SimonDavidson/FlexMan/scheduler/sch_buffer_state.v

// SPDX-License-Identifier: MIT
// Copyright (c) 2026 Simon Davidson, University of Manchester
////////////////////////////////////////////////////////////////////////
//
// sch_buffer_state
//
// Author: Simon D.
// Version: 2.1
// Authors: Simon Davidson & Claude   Last modified: 2026-10-12
//
// Tracks buffer and accelerator state for the scheduler.
//
// Each TASK carries NUM_SLOTS buffer slots, each with a 2-bit mode:
//   2'b00 unused  — skip
//   2'b01 source  — consume (decrement usage count) on completion
//   2'b10 rw      — claim (free=0, full=0) on dispatch; refill on completion
//   2'b11 target  — reserve (free=0) on dispatch; fill on completion
//
// On completion, slots with mode 10 or 11 are marked full with the
// stored #targets count from the completing task.
//
// OVERLAP_ACC_MASK (2026-08-22, Simon Davidson & Claude)
// ------------------------------------------------------
// Default 0 = every accelerator behaves exactly as before.  A set bit gives
// that accelerator a 2-deep buffer tracker, letting it accept its next task
// while the current one drains its output stage (see acc_hw_buffer_tracker's
// DEPTH).  Masked accelerators must drive acc_ready_next_i.
//
// Masked accelerators also get a 2-bit pending-completion counter instead of
// the single pending BIT.  With two tasks in flight, two acc_finished_i pulses
// arriving within one cycle would otherwise be merged by
//    (pending | finished) & ~selected
// and one completion lost for good — its buffers never freed, the scheduler
// stalled.  Unmasked accelerators keep the original single-bit expression
// verbatim, so nothing existing changes.
//
// OVERLAP_DEPTH (2026-10-12): how many tasks a MASKED accelerator may hold in
// flight. Default 2 = exactly the above. 3 gives it a 3-deep tracker
// (acc_hw_buffer_tracker gen_depthn) and a 3-bit pending counter (up to three
// completions may then be outstanding). Unmasked accelerators are unaffected.
//

`define MODE_UNUSED 2'b00
`define MODE_SRC    2'b01
`define MODE_RW     2'b10
`define MODE_TGT    2'b11

module sch_buffer_state
      #(parameter NUM_BUFFERS         = 16,
        parameter BUFF_INDX_SZ        = $clog2(NUM_BUFFERS),
        parameter NUM_HW_ACCELERATORS = 2,
        parameter TGT_ACC_SZ          = $clog2(NUM_HW_ACCELERATORS),
        parameter TGT_COUNT_SZ        = 3,
        parameter NUM_SLOTS           = 6,
        parameter MODE_SZ             = 2,
        // One bit per accelerator; 1 = allow a second task in flight.
        parameter OVERLAP_ACC_MASK    = {NUM_HW_ACCELERATORS{1'b0}},
        // Tasks in flight for a masked accelerator (2 or 3); default 2.
        parameter OVERLAP_DEPTH       = 2,
        // 1 = buffers tolerate more than one outstanding writer (needed with
        // sch_entry's disjoint hint). Default 0 = original behaviour.
        parameter MULTI_WRITER        = 0
       )
       (input  wire                    clk,
        input  wire                    reset,

        // Process info from hardware accelerators:
        input wire [NUM_HW_ACCELERATORS-1:0] acc_busy_i,
        input wire [NUM_HW_ACCELERATORS-1:0] acc_finished_i,
        input wire [NUM_HW_ACCELERATORS-1:0] acc_result_i,

        // Per-accelerator "I can take another task now" level.  Consulted only
        // for accelerators set in OVERLAP_ACC_MASK; tie to 0 otherwise.
        input wire [NUM_HW_ACCELERATORS-1:0] acc_ready_next_i,

        // External buffer pre-fill:
        input wire                     mark_buff_as_full_i,
        input wire  [BUFF_INDX_SZ-1:0] full_buff_id_i,
        input wire  [TGT_COUNT_SZ-1:0] full_buff_usage_i,

        // Dispatch interface from scheduler:
        input wire                                start_new_task_i,
        input wire  [TGT_ACC_SZ-1:0]              tgt_acc_id_i,
        input wire  [NUM_SLOTS*BUFF_INDX_SZ-1:0]  slot_buff_i,
        input wire  [NUM_SLOTS*MODE_SZ-1:0]        slot_mode_i,
        input wire  [NUM_SLOTS*TGT_COUNT_SZ-1:0]   slot_ntgt_i,
        input wire                                 tgt_colour_i,

        // Broadcast current accelerator status:
        output wire [NUM_HW_ACCELERATORS-1:0] acc_available_o,

        // Broadcast current buffer status:
        output wire [NUM_BUFFERS-1:0]  buffers_full_o,
        output wire [NUM_BUFFERS-1:0]  buffers_free_o,
        output wire [NUM_BUFFERS-1:0]  buffers_colour_o,
        output wire [NUM_BUFFERS-1:0]  target_status_o
        );

// Per-accelerator tracker outputs:
wire [NUM_HW_ACCELERATORS-1:0]             acc_free;
wire [NUM_SLOTS*BUFF_INDX_SZ-1:0] tr_slot_buff [0:NUM_HW_ACCELERATORS-1];
wire [NUM_SLOTS*MODE_SZ-1:0]       tr_slot_mode [0:NUM_HW_ACCELERATORS-1];
wire [NUM_SLOTS*TGT_COUNT_SZ-1:0]  tr_slot_ntgt [0:NUM_HW_ACCELERATORS-1];

// Pending-completion queue (one-hot, one bit per accelerator):
reg  [NUM_HW_ACCELERATORS-1:0] acc_process_pending_r;
wire [NUM_HW_ACCELERATORS-1:0] acc_process_pending_nxt;

// Selected finisher (combinatorial):
reg  [NUM_HW_ACCELERATORS-1:0] selected_finisher;
reg  [TGT_ACC_SZ-1:0]          selected_acc_idx;
wire                            post_task_cleanup;

// One-hot buffer action strobes (combinatorial):
reg  [NUM_BUFFERS-1:0] buff_src_consumed;
reg  [NUM_BUFFERS-1:0] buff_rw_claim;
reg  [NUM_BUFFERS-1:0] buff_new_tgt;
reg  [NUM_BUFFERS-1:0] buff_now_full;

// Per-buffer completion data (driven from selected finisher's tracker):
reg  [TGT_COUNT_SZ-1:0] buff_now_ntgt   [0:NUM_BUFFERS-1];

// External mark-as-full one-hot:
reg  [NUM_BUFFERS-1:0] mark_as_full;

// ACC ID one-hot for new task dispatch:
reg [NUM_HW_ACCELERATORS-1:0] new_task_acc;

integer s, c, bi_idx;
reg found;

//-----------------------------------------------------------------
// Pending-completion queue
//-----------------------------------------------------------------
genvar pi;
generate
   for (pi = 0; pi < NUM_HW_ACCELERATORS; pi = pi + 1) begin : gen_pend
      if (((OVERLAP_ACC_MASK >> pi) & 1) == 0) begin : gen_bit
         // Original: at most one completion can ever be outstanding.
         assign acc_process_pending_nxt[pi] =
                  (acc_process_pending_r[pi] | acc_finished_i[pi])
                & ~selected_finisher[pi];
      end else if (OVERLAP_DEPTH >= 3) begin : gen_cntn
         // OVERLAP_DEPTH>=3: up to OVERLAP_DEPTH completions outstanding, so
         // the counter is one bit wider than that needs and must never fill.
         localparam CW = $clog2(OVERLAP_DEPTH + 1) + 1;
         reg  [CW-1:0] cnt_r;
         wire [CW-1:0] cnt_nxt = cnt_r + {{(CW-1){1'b0}}, acc_finished_i[pi]}
                                       - {{(CW-1){1'b0}}, selected_finisher[pi]};
         always @ (posedge clk)
            if (reset) cnt_r <= {CW{1'b0}};
            else       cnt_r <= cnt_nxt;
         assign acc_process_pending_nxt[pi] = (cnt_nxt != {CW{1'b0}});
         // synopsys translate_off
         always @ (posedge clk)
            if (!reset && cnt_r > OVERLAP_DEPTH) begin
               $display("FATAL %m: %0d completions pending, more than OVERLAP_DEPTH %0d",
                        cnt_r, OVERLAP_DEPTH);
               $fatal;
            end
         // synopsys translate_on
      end else begin : gen_cnt
         // Overlapped: count completions so two cannot merge.  Saturates at 3,
         // which is unreachable with a 2-deep tracker but keeps the adder safe.
         reg  [1:0] cnt_r;
         wire       inc     = acc_finished_i[pi] & (cnt_r != 2'd3);
         wire [1:0] cnt_nxt = cnt_r + {1'b0, inc}
                                    - {1'b0, selected_finisher[pi]};
         always @ (posedge clk)
            if (reset) cnt_r <= 2'd0;
            else       cnt_r <= cnt_nxt;
         assign acc_process_pending_nxt[pi] = (cnt_nxt != 2'd0);
      end
   end
endgenerate

always @ (posedge clk)
begin
   if (reset)
      acc_process_pending_r <= 'b0;
   else
      acc_process_pending_r <= acc_process_pending_nxt;
end

//-----------------------------------------------------------------
// Priority-encode the lowest-index pending finisher
//-----------------------------------------------------------------
always @*
begin
   selected_finisher = 'b0;
   selected_acc_idx  = 'b0;
   found             = 1'b0;
   for (s = 0; s < NUM_HW_ACCELERATORS; s = s + 1)
      if (!found && acc_process_pending_r[s])
      begin
         selected_finisher[s] = 1'b1;
         selected_acc_idx     = s[TGT_ACC_SZ-1:0];
         found                = 1'b1;
      end
end

assign post_task_cleanup = |selected_finisher;

//-----------------------------------------------------------------
// External mark-as-full
//-----------------------------------------------------------------
always @ (full_buff_id_i, mark_buff_as_full_i)
begin
   mark_as_full = 'b0;
   if (mark_buff_as_full_i)
      mark_as_full[full_buff_id_i] = 1'b1;
end

//-----------------------------------------------------------------
// Dispatch: decode slot modes and assert buffer action strobes
//-----------------------------------------------------------------
always @*
begin
   buff_rw_claim     = 'b0;
   buff_new_tgt      = 'b0;
   new_task_acc      = 'b0;
   if (start_new_task_i)
   begin
      new_task_acc[tgt_acc_id_i] = 1'b1;
      for (s = 0; s < NUM_SLOTS; s = s + 1)
      begin : dispatch_slot
         reg [BUFF_INDX_SZ-1:0] bid;
         reg [MODE_SZ-1:0]      md;
         bid = slot_buff_i[s*BUFF_INDX_SZ +: BUFF_INDX_SZ];
         md  = slot_mode_i[s*MODE_SZ      +: MODE_SZ];
         case (md)
            `MODE_RW:  buff_rw_claim[bid] = 1'b1;
            `MODE_TGT: buff_new_tgt[bid]  = 1'b1;
            // MODE_SRC: consume now happens on task completion (see below), not
            // dispatch — accelerators stream the buffer live until they finish,
            // so the buffer must stay allocated until the reader completes.
            default:   ;
         endcase
      end
   end
end

//-----------------------------------------------------------------
// Completion: mark output slots full with stored #targets
//-----------------------------------------------------------------
always @*
begin
   buff_now_full     = 'b0;
   buff_src_consumed = 'b0;
   for (bi_idx = 0; bi_idx < NUM_BUFFERS; bi_idx = bi_idx + 1)
      buff_now_ntgt[bi_idx] = 'b0;

   if (post_task_cleanup)
   begin
      for (s = 0; s < NUM_SLOTS; s = s + 1)
      begin : completion_slot
         reg [BUFF_INDX_SZ-1:0] bid;
         reg [MODE_SZ-1:0]      md;
         bid = tr_slot_buff[selected_acc_idx][s*BUFF_INDX_SZ +: BUFF_INDX_SZ];
         md  = tr_slot_mode[selected_acc_idx][s*MODE_SZ      +: MODE_SZ];
         if (md == `MODE_RW || md == `MODE_TGT)
         begin
            buff_now_full[bid]   = 1'b1;
            buff_now_ntgt[bid]   =
               tr_slot_ntgt[selected_acc_idx][s*TGT_COUNT_SZ +: TGT_COUNT_SZ];
         end
         else if (md == `MODE_SRC)
            // Decrement the read usage-count (and free on the last consumer)
            // when the consuming task COMPLETES, not when it dispatches — closes
            // the write-after-read hazard against accelerators that stream the
            // buffer live from shared memory.
            buff_src_consumed[bid] = 1'b1;
      end
   end
end

//-----------------------------------------------------------------
// Instantiate per-accelerator buffer trackers
//-----------------------------------------------------------------
genvar ai;
generate
   for (ai = 0; ai < NUM_HW_ACCELERATORS; ai = ai + 1) begin : gen_acc
      acc_hw_buffer_tracker #(
         .NUM_SLOTS(NUM_SLOTS),
         .BUFF_INDX_SZ(BUFF_INDX_SZ),
         .TGT_COUNT_SZ(TGT_COUNT_SZ),
         .MODE_SZ(MODE_SZ),
         .DEPTH((((OVERLAP_ACC_MASK >> ai) & 1) != 0) ? OVERLAP_DEPTH : 1)
      ) hw_n (
         .clk(clk),
         .reset(reset),
         .new_task_i(new_task_acc[ai]),
         .slot_buff_i(slot_buff_i),
         .slot_mode_i(slot_mode_i),
         .slot_ntgt_i(slot_ntgt_i),
         .task_finished_i(selected_finisher[ai]),
         .acc_ready_next_i(acc_ready_next_i[ai]),
         .acc_free_o(acc_free[ai]),
         .slot_buff_o(tr_slot_buff[ai]),
         .slot_mode_o(tr_slot_mode[ai]),
         .slot_ntgt_o(tr_slot_ntgt[ai])
      );
   end
endgenerate

assign acc_available_o = acc_free;

//-----------------------------------------------------------------
// Instantiate per-buffer state entries
//-----------------------------------------------------------------
genvar bi;
generate
   for (bi = 0; bi < NUM_BUFFERS; bi = bi + 1) begin : gen_buf
      buffer_state_entry #(.TGT_COUNT_SZ(TGT_COUNT_SZ),
                           .MULTI_WRITER(MULTI_WRITER)) buffer_n (
         .clk(clk),
         .reset(reset),
         .mark_as_full_i(mark_as_full[bi]),
         .mark_buff_usage_i(full_buff_usage_i),
         .buff_new_tgt_i(buff_new_tgt[bi]),
         .buff_new_usage_count_i({TGT_COUNT_SZ{1'b0}}),
         .buff_new_colour_i(tgt_colour_i),
         .buff_rw_claim_i(buff_rw_claim[bi]),
         .buff_rw_colour_i(tgt_colour_i),
         .buff_now_full_i(buff_now_full[bi]),
         .buff_now_usage_count_i(buff_now_ntgt[bi]),
         .buff_content_consumed_i(buff_src_consumed[bi]),
         .buff_usage_count_o(),
         .buff_colour_o(buffers_colour_o[bi]),
         .buff_free_o(buffers_free_o[bi]),
         .buff_full_o(buffers_full_o[bi])
      );
   end
endgenerate

//-----------------------------------------------------------------
// Per-buffer task result register file (used by CHECK instruction)
//-----------------------------------------------------------------
reg [NUM_BUFFERS-1:0] target_status_r;

always @ (posedge clk)
begin
   if (reset)
      target_status_r <= 'b0;
   else if (post_task_cleanup)
   begin
      for (s = 0; s < NUM_SLOTS; s = s + 1)
      begin : result_slot
         reg [BUFF_INDX_SZ-1:0] bid;
         reg [MODE_SZ-1:0]      md;
         bid = tr_slot_buff[selected_acc_idx][s*BUFF_INDX_SZ +: BUFF_INDX_SZ];
         md  = tr_slot_mode[selected_acc_idx][s*MODE_SZ      +: MODE_SZ];
         if (md == `MODE_TGT || md == `MODE_RW)
            target_status_r[bid] <= acc_result_i[selected_acc_idx];
      end
   end
end

assign target_status_o = target_status_r;

endmodule // sch_buffer_state
