SimonDavidson/FlexMan/ipSnnAcc/update_state_for_neuron.v

// SPDX-License-Identifier: MIT
// Copyright (c) 2026 Simon Davidson, University of Manchester
// =============================================================================
// Module: update_state_for_neuron
//
// 3-cycle pipeline (was 2-cycle).  The extra stage registers the potential
// multiplier output and spike before the output mux, breaking the previously
// critical combinatorial path (mul -> mux -> packer barrel shifter ->
// output_buffer) that failed 200 MHz timing.  Functionally identical to the
// prior 2-cycle version; ported from snnAcc/update_state_for_neuron.v (which
// already closes 200 MHz).  The valid/taken handshake absorbs the +1 cycle, so
// neuron_processing needs no change.
//
//   ST_IDLE : syn_curr × syn_dcy multiply runs combinatorially.
//             On neuron_valid_i: capture potential_r, threshold_r,
//             decayed_syn_curr_r; advance to ST_C1.
//
//   ST_C1   : potential_r × pot_dcy multiply runs combinatorially.
//             spike wire computed from potential_r >= threshold_r.
//             On clock edge: capture decayed_potential_r, spike_r;
//             advance to ST_C2.
//
//   ST_C2   : result_valid_o=1.  All outputs driven from registered
//             values — no multiplier or comparator on this path.
//             Stall until result_taken_i, then return to ST_IDLE.
//
// Critical paths after this change:
//   ST_IDLE  : syn_curr_i → 32x32 mul → register  (reg-to-reg)
//   ST_C1    : potential_r → 32x32 mul → register  (reg-to-reg)
//   ST_C2    : registers → mux → outputs            (<2 ns)
// =============================================================================

`timescale 1ns / 1ps

module update_state_for_neuron # (
	parameter SYN_CURR_SLICE_BITS  = 32,   // S_syn  (signed)
	parameter POT_SLICE_BITS       = 32,   // S_pot  (signed)
	parameter BIAS_CURR_SLICE_BITS = 32,
	parameter THRESH_SLICE_BITS    = 32,
	parameter SYN_DECAY_BITS       = 32,   // D_syn  (unsigned Q0.D_syn)
	parameter POT_DECAY_BITS       = 32    // D_pot  (unsigned Q0.D_pot)
     )
    (
    // Clock and reset
    input  wire                        clk,
    input  wire                        reset,            // Active-high asynchronous reset

    // Input interface (valid/taken handshake)
    input  wire                                   neuron_valid_i,   // Input transaction valid
    input  wire signed [SYN_CURR_SLICE_BITS-1:0]  syn_curr_i,
    input  wire signed [POT_SLICE_BITS-1:0]       potential_i,
    input  wire signed [BIAS_CURR_SLICE_BITS-1:0] bias_curr_i,
    input  wire signed [THRESH_SLICE_BITS-1:0]    threshold_i,
    input  wire                                   sub_on_fire_i,
    input  wire        [SYN_DECAY_BITS-1:0]       syn_curr_decay_mult_i,   // Q0.D_syn unsigned
    input  wire        [POT_DECAY_BITS-1:0]       potential_decay_mult_i,  // Q0.D_pot unsigned
    output wire                                   neuron_taken_o,  // Acknowledge to upstream

    // Output interface (valid/taken handshake)
    output wire                                   result_valid_o,
    output wire signed       [POT_SLICE_BITS-1:0] potential_o,
    output wire signed  [SYN_CURR_SLICE_BITS-1:0] syn_curr_o,
    output wire                                   spike_o,
    input  wire                                   result_taken_i   // Acknowledge from downstream
);

    // =========================================================================
    // State machine: ST_IDLE → ST_C1 → ST_C2 → (stall or ST_IDLE)
    // =========================================================================
    localparam [1:0] ST_IDLE = 2'd0, ST_C1 = 2'd1, ST_C2 = 2'd2;
    reg [1:0] state_r;

    always @(posedge clk) begin
        if (reset)
            state_r <= ST_IDLE;
        else case (state_r)
            ST_IDLE: if (neuron_valid_i) state_r <= ST_C1;
            ST_C1:                       state_r <= ST_C2;
            ST_C2:   if (result_taken_i) state_r <= ST_IDLE;
            default:                     state_r <= ST_IDLE;
        endcase
    end

    // =========================================================================
    // Potential sum + saturation (combinatorial, evaluated in ST_IDLE)
    // Registered into potential_r and threshold_r on the IDLE→C1 edge.
    // =========================================================================
    wire signed [POT_SLICE_BITS+1:0] new_potential;
    wire                             pot_overflow, pot_underflow;
    wire signed [POT_SLICE_BITS-1:0] saturated_potential;

    assign new_potential  = potential_i + bias_curr_i + syn_curr_i;
    assign pot_overflow   = (~new_potential[POT_SLICE_BITS-1] &&
                             (new_potential[POT_SLICE_BITS+1:POT_SLICE_BITS] != 2'b00));
    assign pot_underflow  = ( new_potential[POT_SLICE_BITS-1] &&
                             (new_potential[POT_SLICE_BITS+1:POT_SLICE_BITS] != 2'b11));
    assign saturated_potential = pot_overflow  ? {1'b0, {(POT_SLICE_BITS-1){1'b1}}} :
                                 pot_underflow ? {1'b1, {(POT_SLICE_BITS-1){1'b0}}} :
                                                 new_potential[POT_SLICE_BITS-1:0];

    reg signed [POT_SLICE_BITS-1:0]    potential_r;
    reg signed [THRESH_SLICE_BITS-1:0] threshold_r;

    always @(posedge clk) begin
        if (reset) begin
            potential_r <= {POT_SLICE_BITS{1'b0}};
            threshold_r <= {THRESH_SLICE_BITS{1'b0}};
        end else if (state_r == ST_IDLE && neuron_valid_i) begin
            potential_r <= saturated_potential;
            threshold_r <= threshold_i;
        end
    end

    // =========================================================================
    // Shared multiplier — mux selects operands based on pipeline stage:
    //   ST_IDLE / ST_C2 : syn_curr_i    × syn_curr_decay_mult_i
    //   ST_C1            : potential_r  × potential_decay_mult_i
    //
    // Signed (data) × unsigned (Q0.D decay): we sign-extend the signed operand
    // and zero-extend the unsigned decay into common widths large enough for
    // both stages, then take the full (signed) product. The high `S` bits of
    // the product, starting above the `D` fractional bits of the decay, are
    // the Q-scaled result. Synthesis will trim any bits we never consume.
    // =========================================================================
    localparam MUL_A_BITS = (POT_SLICE_BITS > SYN_CURR_SLICE_BITS)
                          ? POT_SLICE_BITS : SYN_CURR_SLICE_BITS;
    localparam MUL_B_BITS = (POT_DECAY_BITS > SYN_DECAY_BITS)
                          ? POT_DECAY_BITS : SYN_DECAY_BITS;
    localparam MUL_R_BITS = MUL_A_BITS + MUL_B_BITS;

    wire signed [MUL_A_BITS-1:0] mul_a;
    wire        [MUL_B_BITS-1:0] mul_b;
    wire signed [MUL_R_BITS-1:0] mul_result;

    assign mul_a = (state_r == ST_C1)
        ? {{(MUL_A_BITS-POT_SLICE_BITS){potential_r[POT_SLICE_BITS-1]}},      potential_r}
        : {{(MUL_A_BITS-SYN_CURR_SLICE_BITS){syn_curr_i[SYN_CURR_SLICE_BITS-1]}}, syn_curr_i};
    assign mul_b = (state_r == ST_C1)
        ? {{(MUL_B_BITS-POT_DECAY_BITS){1'b0}}, potential_decay_mult_i}
        : {{(MUL_B_BITS-SYN_DECAY_BITS){1'b0}}, syn_curr_decay_mult_i};

    // F1 fix (2026-06-07, ported here 2026-06-10): signed*signed decay. The
    // bare `mul_a * mul_b` was evaluated UNSIGNED (mul_b is unsigned),
    // corrupting decay of negative operands — RTL stored EMU_value + mult for
    // every negative syn/pot (caught by the e2e frame-1 encoder divergence).
    // Zero-extend mul_b and cast both signed, matching snnAcc/annAcc/fmiSnnAcc.
    assign mul_result = $signed(mul_a) * $signed({1'b0, mul_b});

    // Decayed syn_curr: registered on IDLE→C1 edge (multiply ran in ST_IDLE).
    // Extract high SYN_CURR_SLICE_BITS bits above the SYN_DECAY_BITS fraction.
    reg signed [SYN_CURR_SLICE_BITS-1:0] decayed_syn_curr_r;

    always @(posedge clk) begin
        if (reset)
            decayed_syn_curr_r <= {SYN_CURR_SLICE_BITS{1'b0}};
        else if (state_r == ST_IDLE && neuron_valid_i)
            decayed_syn_curr_r <= mul_result[SYN_DECAY_BITS + SYN_CURR_SLICE_BITS - 1
                                              : SYN_DECAY_BITS];
    end

    // Decayed potential + spike: registered on C1→C2 edge (multiply ran in ST_C1).
    // Extract high POT_SLICE_BITS bits above the POT_DECAY_BITS fraction.
    wire spike_wire = (potential_r >= threshold_r);

    reg signed [POT_SLICE_BITS-1:0] decayed_potential_r;
    reg                              spike_r;

    always @(posedge clk) begin
        if (reset) begin
            decayed_potential_r <= {POT_SLICE_BITS{1'b0}};
            spike_r             <= 1'b0;
        end else if (state_r == ST_C1) begin
            decayed_potential_r <= mul_result[POT_DECAY_BITS + POT_SLICE_BITS - 1
                                               : POT_DECAY_BITS];
            spike_r             <= spike_wire;
        end
    end

    // =========================================================================
    // ST_C2 outputs: all from registered values — no multiplier on this path
    // =========================================================================
    assign result_valid_o = (state_r == ST_C2);
    assign spike_o        = spike_r;
    assign syn_curr_o     = decayed_syn_curr_r;
    assign potential_o    = spike_r
        ? (sub_on_fire_i
            ? decayed_potential_r - {{(POT_SLICE_BITS-THRESH_SLICE_BITS){threshold_r[THRESH_SLICE_BITS-1]}}, threshold_r}
            : {POT_SLICE_BITS{1'b0}})
        : decayed_potential_r;

    // Upstream handshake: accept new neuron only when downstream takes result.
    assign neuron_taken_o = result_taken_i;

endmodule
