SimonDavidson/FlexMan/(commit log)

2026-05-11 Switch .gitignore to whitelist: track only .v, .bsh, .md, README, LICENSE
2026-05-13 Implement 6-slot TASK instruction and RW buffer mode in scheduler; rename annAcc modules
    scheduler:
    - Extend TASK to 64-bit (two 32-word): slots 0-2 (short: mode+id) in word 1,
    slots 3-5 (long: mode+id+ntgt) in word 2
    - Add MODE_RW (2'b10): buffer claimed busy on dispatch, refilled on completion
    - Add buff_rw_claim_i to buffer_state_entry; priority above buff_now_full
    - Wire colour check in sch_entry (was tracked but never checked)
    - Expand acc_hw_buffer_tracker to store all 6 slots (mode+id+ntgt)
    - Fix stale task_w2_r bug: entry packing now reads inst_word directly at
    load time rather than the one-cycle-delayed task_w2_r register
    - Fix sch_entry needs_free for RW mode (was incorrectly b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
    [acc_hw_buffer_tracker.v, acc_snn_processor.v, buffer_state_entry.v, constants.v, neuron_processing.v, sch_buffer_state.v, sch_entry.v, sch_table.v]
2026-05-13 Add fill_unit accelerator and flexman top-level integration
    fill_unit (acc_id=4) fills a scheduler-managed buffer with a 32-bit
    constant. A FILL instruction enters the scheduler table so the fetch
    pipeline keeps running; fill_unit asserts acc_finished_o when done,
    unblocking any consumer tasks that were waiting on the buffer.
    New files:
    fillUnit/fill_unit.v — FSM: IDLE→BBA_WAIT→FILLING→DONE;
    25-bus one-hot memory select table
    (AXI-initialised per buffer)
    fillUnit/tb_fill_unit.v — 5 tests: basic fill, memory type
    selection, BBA back-pressure, memory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
2026-05-14 Add FPGA synthesis wrapper with instantiated on-chip BRAMs
    Introduces flexman_fpga_wrap — a synthesisable top-level that closes all
    external memory buses from flexman.v into inferred Xilinx 7-series BRAMs
    (RAMB36/RAMB18). Three shared BRAM primitives are added to shared/:
    bram_sp (single-port, read-first), bram_sdp (simple dual-port), and
    bram_tdp (true dual-port, used for bba_mem). All *_wait_i ports are tied
    low; program memory is writable via a dedicated prog_wr_* port; spike
    memory read-back ports are exposed externally. Elaboration clean (0
    errors) verified with elab_fpga_wrap.bsh. Also updates
    SCHEDULER_DESIGN.md to reflect the 5-accelerator / fill-unit topology.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
    [bram_sdp.v, bram_sp.v, bram_tdp.v, flexman_fpga_wrap.v]
2026-05-14 Add XDC constraints for xc7s50fgga484-1 and update project script
    flexman_fpga_wrap.xdc covers the Spartan-7 50T target: clock definition
    (create_clock, 100 MHz placeholder), false path on reset, input/output
    delay constraints (2 ns / 0.5 ns), CFGBVS/CONFIG_VOLTAGE at 3.3 V, and
    commented-out PACKAGE_PIN stubs for all 292 ports grouped by function.
    A note at the top explains that the full port count exceeds the 250 user
    I/O available on xc7s50fgga484-1 and suggests connecting AXI/spike buses
    to on-chip IP instead of package pins.
    create_vivado_project.tcl updated to target xc7s50fgga484-1 and to add
    the XDC to constrs_1. .gitignore extended to track *.xdc files.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
    [flexman_fpga_wrap.xdc]
2026-05-15 Add fmiSnnAcc: FMI variant of snnAcc with per-neuron decay and adaptive threshold
    Derived from snnAcc; extends it for the FMI speech-quality-predictor SNN:
    - Per-neuron dcy_syn/dcy_mem loaded from external memory banks (replaces
    global AXI decay registers 0x68/0x6C)
    - Adaptive threshold support (has_ada) for group3: ada state, b_eff, dcy_ada,
    scl_ada memories; 3-cycle FSM path when enabled
    - Bias current removed (FMI model has none)
    - Y-dimension AXI registers removed; Y hardwired to 1 at instantiation boundary
    (FMI model uses 1D temporal convolution only)
    - All modules and files named with acc_fmiSnn_ prefix
    - Both testbenches pass under Xcelium 21.03 (7 unit tests, 3 integration test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
    [acc_fmiSnn_processor.v, act_index_generator.v, dataline_cache_with_xy.v, neuron_processing.v, packer.v, slice_and_align.v, spike_processing.v, sram_bram.v]
2026-05-19 Add IOB output registers to flexman_fpga_wrap
    All output ports were combinatorial wires, making Vivado's output-delay
    analysis count the source register's clock tree insertion delay against the
    external timing budget. Add (* IOB = "TRUE" *) registered stages at the
    pad boundary for sys_ack_o, sys_data_o, nxt_*_pulse_o,
    cm_config_finished_o, and the three spike readback data outputs.
    The fabric-to-IOB-FF path is now a register-to-register constraint against
    the full clock period. set_output_delay constrains only the IOB-FF →
    output-buffer path (~1 ns), which easily meets the 2 ns budget.
    External consumers see +1 cycle latency on all outputs; spike readback
    data is 2 cycles after addres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
2026-05-19 Add pipeline register after multiplier to meet 10 ns timing constraint
    3-cycle pipeline in update_state_for_neuron replaces 2-cycle: register stage
    inserted after the 32×32 multiply so the long multiply→accumulate path is
    broken and Vivado can close timing on the xc7s50 target.
    [tb_update_state_for_neuron.v, update_state_for_neuron.v]
2026-05-19 Replace scheduler dedicated ports with AXI bus interface
    Removes start_program_i, program_addr_i, prog_wr_en_i, prog_wr_addr_i,
    prog_wr_data_i from all levels; all program loading and control now go
    through the shared sys_req/sys_addr/sys_data AXI bus. Implements AXI
    decode for control writes (LOAD_PC/START/CONTINUE/PAUSE/UNPAUSE), status
    reads (CURRENT_PC/ACTIVE/BUFF_*), and prog-mem writes (0xD000_0000 range).
    Scheduler sys_ack_o is now driven correctly instead of stuck at zero.
    Testbench updated to drive start via axi_write; both test programs pass.
    [flexman.v, flexman_fpga_wrap.v, flexman_fpga_wrap.xdc, scheduler.v, tb_scheduler.v]
2026-05-19 Update ISA_REFERENCE: add MARK_BUFF_FULL and prog-mem write range
    - Control commands table: add canonical addresses (0xE0N0_0000 form)
    for all five existing commands plus new MARK_BUFF_FULL (reg 5,
    0xE050_0000) with data-word encoding and usage description
    - Status registers table: fix copy-paste error (BUFF_FULL was shown
    at 6'b00_0001 instead of 6'b00_0010); add canonical addresses for
    all status registers
    - New section: Program Memory write range (0xD000_0000–0xD0FF_FFFF),
    word-address derivation formula, ordering requirement before START
    - Programming notes: add note 6 (MARK_BUFF_FULL vs FILL distinction);
    renumber subsequent notes to 7–9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
2026-05-20 Add sp_skip_neuron_r mode to snnAcc and ipSnnAcc
    New 1-bit config register at AXI offset 0x9C. When set, spike_processing
    runs normally but neuron_processing is skipped; acc_finished_o fires as
    soon as spike_processing completes. Supports two-pass recurrent layers
    (W_in pass 1, W_rec pass 2) sharing the same syn_curr buffer without
    an intermediate decay or threshold step.
    [acc_snn_processor.v]
2026-05-20 Add back-to-back beat tests to tb_syn_curr_update
    T7 holds act_value stable across 4 contiguous beats; T8 changes
    act between beats to lock down that syn_curr_update samples
    act_value_i combinationally on the write cycle (not latched at
    accept), which is what makes spike_processing's "hold act stable
    across a pass" invariant the load-bearing contract.
2026-05-20 Gate weight_index_valid_full on act_data_valid_i in annAcc
    Make the activation/weight lockstep contractual in full mode by
    ANDing act_data_valid_i into weight_index_valid_full, matching the
    conv and sparse paths. Previously full mode relied on cache-latency
    parity between act_cache and weight_cache for correctness at startup;
    that emergent guarantee would break if the two memory paths picked
    up different pipeline depths (e.g. the MAC pipeline reg on the
    xczu7ev FPGA timing-closure path). doing_weight_pass_r is left as
    a sticky flag so running_weight_pass_o still asserts immediately and
    spike_proc_finished_o semantics are unchanged.
    Verified: tbWeightGen PASS, tbAccSNN PASS (RELU/LUT/ABS).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
    [weight_generator.v]
2026-05-27 Latch act_value on accept in annAcc syn_curr_update (timing closure)
    Register both weight_value_i and act_value_i in the accept cycle and
    drive the MAC from act_value_r / weight_value_r. Previously only the
    weight side was pipelined; now both operands of the multiplier come
    from registers latched on the same cycle, splitting the critical path
    across the DSP and giving the synthesiser a clean accept-cycle barrier
    for the 200MHz xczu7ev target.
    tb_syn_curr_update T9 added as a regression: poisons act_value
    between the accept and write cycles of one beat. With the new RTL
    the latched act drives the MAC and sram[22] = 88 + 5*4 = 108; with
    the pre-fix live-act behaviour it would have written 8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
    [syn_curr_update.v, tb_syn_curr_update.v]
2026-05-29 Fix full-mode weight slice counter + add non-uniform regression tests
    In all four weight_generator.v variants the flat slice counter
    out_elem_count_r reset per input neuron for conv/sparse modes but only
    at the end of the entire pass for full mode. When the inner output
    loop wrapped (out_x_index_r resets to 0 at out_x_end_of_row), the
    weight cache kept feeding the same word's remaining slices instead of
    fetching the next input column's word, double-adding contributions
    into outputs 0..out_x_len-1.
    Triggered when weights_per_word x rows_per_neuron > out_x_len x out_y_len.
    Latent in production siren-detection layer geometries (which hit the
    boundary exactly), but live in all four standalone t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
    [tb_acc_fmiSnn_processor.v, tb_acc_snn_processor.v, weight_generator.v]
2026-05-29 Parameterise decay multiplier width across LIF accelerators
    update_state_for_neuron.v gains SYN_DECAY_BITS / POT_DECAY_BITS
    parameters (default 32) and uses them on the decay-multiplier inputs.
    Width of the multiplier result no longer locked to the same width as
    the syn_curr / pot slices. neuron_processing.v exposes the same two
    parameters and passes them through.
    Also widens the raw update_potential_o / updated_syn_curr_o outputs to
    their proper signed slice widths inside neuron_processing.v and
    sign-extends to 32 bits at the left-justify case-block input so the
    existing 32-bit packer paths see a properly-signed quantity.
    Affects snnAcc, ipSnnAcc, annAcc. fmiSnnAcc already had its own de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
    [neuron_processing.v, update_state_for_neuron.v]
2026-05-29 Dispatch path fixes: target_acc latch + cm-gated start + cm_busy back-pressure
    Three orthogonal but related changes that together let real TASKs
    dispatch cleanly through scheduler -> config_manager -> accelerator in
    a multi-acc top.
    Change A (top + scheduler + config_manager): accelerators were starting
    on the raw sch_start_new_block pulse before config_manager had finished
    pushing per-task cfg_mem to them. The pulse also drove an unlatched
    sch_target_acc that went stale by the time per-acc gating ran. Now
    config_manager.cm_tgt_acc_o is wired out, top-level acc_start_new_block
    is gated by cm_config_finished_o, and accelerator instances are fed
    cm_tgt_acc (zero-extended) instead of sch_targe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
    [acc_fmiSnn_processor.v, acc_snn_processor.v, config_manager.v, flexman.v, sch_table.v, scheduler.v, tb_sch_table.v, tb_scheduler.v]
2026-05-30 Decay multipliers into cfg_mem: add 0x18/0x1C decode to LIF wrappers
    Mirror the task_ctrl pattern: add two new register decode cases at
    AXI offset 0x18 (np_syn_curr_decay_mult_r) and 0x1C (np_pot_decay_mult_r)
    inside the cfg_mem push window (offsets 0x00..0x3C). Both aliases of
    the existing 0x68/0x6C — last write wins. config_manager pushes
    cfg_mem words 6 and 7 here on every TASK dispatch, so each cfg_id can
    carry its own α/β.
    snnAcc / ipSnnAcc / siren_ipsnn (the canonical and renamed LIF flavours)
    get both cases. annAcc gets only 0x1C (it has no syn_curr decay path).
    fmiSnnAcc unchanged — its decays come from memory (per-neuron base-addr
    registers), not from a layer-wide Q0.32 const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
2026-05-31 scheduler: LOOPEND completion barrier to close cross-timestep WAR hazard
    LOOPEND now stalls until the table is empty AND all accelerators are idle
    (all_tasks_drained = table_empty & ~|acc_busy_i) before branching/falling
    through, so each loop iteration (= SNN timestep) is a global sync boundary.
    This prevents the next timestep's tasks from racing the current timestep's
    still-in-flight tasks on reused RW state buffers (potentials, syn_currents).
    Note: table_empty alone is only a *dispatch* barrier (entries delete on
    dispatch, sch_table.v:113); NXT shares this limitation (left unchanged).
    tb_scheduler: add Program 3 (phase 2) - a 3-iteration LOOP with recurrent RW
    buffers + a consumed inter-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
    [scheduler.v, tb_scheduler.v]
2026-05-31 fill_unit: add IDX_SHARED_DATA + shared_data port for siren_detector pool
    Pure additive change in preparation for the shared activation/spike memory
    pool refactor in siren_detector_top. Bumps NUM_MEM_TYPES from 25 to 26 and
    adds:
    - localparam IDX_SHARED_DATA = 25
    - new output port group shared_data_wr_o / addr_o / data_o + wait_i input
    - selected_wait term for the new destination
    - gating assign: shared_data_wr_o = do_write & mem_sel_r[IDX_SHARED_DATA]
    siren_detector_top.v and top_module/flexman.v both have the new port wired
    unconnected on their u_fill instantiations so the build stays green. The
    new IDX/port isn't reachable yet — wiring it up to the shared pool is the
    next step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
2026-05-31 scheduler: free source buffers on consumer completion, not dispatch (WAR fix)
    The SOURCE usage-count decrement (and buffer free) fired on the consuming
    task's DISPATCH (sch_buffer_state.v start_new_task_i path), so a following
    writer could claim and overwrite a buffer while the reader was still streaming
    it from live shared memory -> write-after-read corruption. Not caught by the
    LOOPEND/NXT barriers; it also bites read-then-write within a single loop body.
    Move buff_src_consumed from the dispatch always-block to the completion block
    (keyed on the finishing task's stored SOURCE slots). The reader now holds the
    buffer until it completes, so a later writer (needs free) is held to the
    reader's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
    [acc_hw_buffer_tracker.v, buffer_state_entry.v, sch_buffer_state.v, tb_scheduler.v]
2026-05-31 scheduler: strict in-order dispatch (remove out-of-order hazard class)
    An audit found out-of-order dispatch (lowest-index *ready* entry) could violate
    inter-task ordering on a shared buffer with no rename/reorder-buffer to protect
    it: WAW inversion, TARGET-producer ABA, RW-writer overtaking a stalled reader.
    Restrict sch_table selection to the oldest entry (index 0; entries compact
    toward 0) and only when ready - a younger ready entry can never pass a stalled
    older one. Also gate 'launching' on select_to_go (not |ready_to_go): otherwise
    a not-ready head with a younger ready entry pulses dispatch with nothing
    deleted, repeating every cycle.
    This fixes the TARGET-writer hazards outright (fre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
    [sch_table.v, tb_scheduler.v]
2026-05-31 shared_pool: extract reusable N-bank pool arbiter; retrofit siren
    Add shared/shared_pool.v — a parameterized (NUM_BANKS, NUM_REQ) interleaved
    single-port pool arbiter with registered read-data return, generalising the
    inline 2-bank arbiter that was hand-written in siren_detector_top.v. Banks are
    external (top/tb instantiates them); the module is arbiter + read-mux only,
    using flattened Verilog-2001 requester/bank buses and strict requester-index
    priority.
    Retrofit siren_detector_top.v to instantiate shared_pool #(NUM_BANKS=2,
    NUM_REQ=10) instead of the inline arbiter — no port or behaviour change. All
    T1-T6a still pass. This is the reusable foundation for the flexman migration
    (4 banks,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
2026-06-01 tb_flexman: add inter-accelerator dataflow test (T3); fix snnAcc config
    T3 proves the shared pool's reason for existing: a buffer produced by one
    accelerator's spike output is consumed by another accelerator's act input,
    through the same physical pool word. snn0 reads input spikes, fires, and
    writes its spike output to pool buffer MID (pool[8]); snn1 reads MID as its
    act input and computes a non-zero syn_curr from it. The scheduler holds snn1
    until snn0 has produced MID (producer/consumer buffer dependency). Had snn0
    not fired, pool[8] would be 0 and snn1's result 0 — so snn1's non-zero,
    snn0-dependent output is the dataflow proof.
    Two flexman.v fixes were needed to run real snnAcc tasks: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
    [flexman.v, tb_flexman.v]
2026-06-01 annAcc slice fix in flexman; fill_unit cleanup (remove orphan pooled ports)
    annAcc fix: u_ann was missing the SP_SYN_CURR_SLICE_BITS=32 override (matches
    siren), so a real task on annAcc in flexman would slice 32-bit syn_curr to 0 the
    same way snn0/snn1 did. Added it.
    fill_unit cleanup (now unblocked — both tops route act/spike/syn_curr + Hadamard
    buffers through shared_data): removed the per-accelerator act/spike/syn_curr and
    hd_src_a/b/z/r write ports, their IDX_* constants, and the corresponding
    selected_wait terms and do_write assigns from fillUnit/fill_unit.v. Kept
    weight/bias_curr/thresh/pot dedicated ports and shared_data; retained indices
    keep their original bit positions so the h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
    [fill_unit.v, flexman.v, tb_fill_unit.v]
2026-06-01 ipSnnAcc: register syn_curr MAC operands to close timing (Phase 1)
    Pipeline the weight x activation multiply in ipsnn_syn_curr_update by
    registering the operands (weight_value_r/act_value_r) at capture, mirroring
    annAcc/syn_curr_update. The multiply now starts from registers instead of
    chaining combinationally from the weight BRAM read -> multiply -> add ->
    data-pool write. Latency-neutral (result still written when req_pending_r=1).
    Post-route WNS at 200 MHz on xczu7ev: -1.390 -> -1.289 ns; the weight x
    activation failing-path group is eliminated. Residual violation is now wholly
    the neuron-decay path (pot_wb_packer), addressed in Phase 2.
    Also de-hardcode the activation operand width via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
    [syn_curr_update.v]
2026-06-03 annAcc: output requantisation stage (bin-point align + round + saturate)
    The annAcc emitted |syn_curr| at the accumulator bin point and the output slice
    kept only the low N bits — fractional noise, not the magnitude at the trained
    output step. There was never an output requant: bin_point_syn_curr was a
    declared-but-unused port since the initial commit.
    Add a requant stage in annAcc/neuron_processing.v between act_out_w and the
    left-justify: round-half-up, arithmetic shift right by
    (bin_point_syn_curr - np_out_bin_point), then unsigned-saturate to the
    act_out_sz field width. Reuses the dead bin_point_syn_curr_i hook; adds one
    config register np_out_bin_point (acc_snn_processor.v, AXI 0xA4)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
    [acc_snn_processor.v, neuron_processing.v, tb_neuron_processing.v]
2026-06-03 docs: add neuron_model.md — neuron equations as implemented in RTL
    Canonical reference for what the accelerators actually compute (LIF, readout LI,
    annAcc feedforward+requant), verified against the RTL. Flags the one divergence
    from the reference: bias enters the membrane (beta-shaped) not the current
    (alpha-shaped) — the pending bias fix.
2026-06-07 verif: shared verification library (golden neuron model + BFMs)
    Phase 0 of the test-coverage uplift. Adds a reusable verif/ library, pulled
    in via `include "../verif/xxx.vh" the same way shared/constants.v is:
    checks.vh self-checking tasks (!== so X/Z fails) + PASS/FAIL epilogue
    ($fatal on failure -> non-zero exit) + watchdog
    np_ref.vh ONE golden neuron model for all four variants:
    LIF (snnAcc/ipSnnAcc), ANN threshold/decay/requant (annAcc),
    FMI per-neuron decay + adaptive (fmiSnnAcc). Mirrors each RTL
    multiply form exactly; separate ideal-signed helper for
    directed spec-intent checks.
    sram_bfm.vh synchr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
    [tb_np_ref_selftest.v]
2026-06-07 snnAcc: aggressive neuron tests (template) — update_state + neuron_processing
    Phase 2A (partial). Rewrites two of the three user-named modules' tests onto
    the verif/ library with constrained-random-vs-golden:
    tb_update_state_for_neuron: directed corner cases (golden-checked) + 3000
    random vectors vs np_ref_lif + saturation-quirk assertion + F1 negative-
    decay probe (loud NOTE). 9022 checks, 0 failures.
    tb_neuron_processing: whole layers (16/33 neurons) vs per-neuron np_ref_lif,
    spike-word packing across the 32-neuron boundary, clear_pot, sub_on_fire,
    read-path back-pressure, decay-rate sweeps. 282 checks, 0 failures.
    These two become the canonical pattern the varia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
    [tb_neuron_processing.v, tb_update_state_for_neuron.v]
2026-06-07 snnAcc: aggressive spike_processing test (full-mode MAC golden)
    Phase 2A complete. Rewrites tb_spike_processing onto a mapping-independent
    accumulation golden: with a uniform weight w, every input spike adds +w to
    every output, so syn_curr[j] = init[j] + popcount*sign_extend_W(w). Validated
    across 2x2/4x2/4x4 grids, 8- and 16-bit weights, RMW initial values, and
    random memory back-pressure. 820 checks, 0 failures.
    Surfaced finding F4 (NOTE in the test output): with ALL-ZERO activations,
    full-mode spike_processing still accumulates the weights (spike gating has no
    effect in this config; syn=4*w instead of 0). The old test used all-1
    activations so never exercised this. Bug vs intended dense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
    [tb_spike_processing.v]
2026-06-07 variants: port aggressive neuron tests to ipSnnAcc/annAcc/fmiSnnAcc
    Phase 4 (partial). Reuses the shared np_ref golden across all accelerator
    variants:
    ipSnnAcc update_state + neuron_processing : np_ref_lif (9012 + 282 checks)
    annAcc ann_update_state_for_neuron : np_ann_threshold/decay (6012)
    fmiSnnAcc update_state (per-neuron + ada) : np_ref_fmi (12016, plain+ada)
    Resolves F2: the ipSnnAcc tests now PASS. F2 was a STALE-TEST timing bug
    (old fixed-cycle sampling read potential_o before result_valid, hence X on
    the spike path), NOT an RTL fault — the 2-cycle pipeline is correct, proven
    bit-for-bit vs np_ref_lif over 3000 random vectors. The depth-agnostic
    VT_CONSUME poll d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
    [tb_neuron_processing.v, tb_update_state_for_neuron.v]
2026-06-07 verif: consolidate findings — F2 resolved, spike no-spike finding -> F6
    - F2 marked RESOLVED (ipSnnAcc tests pass; was a stale-test sampling bug).
    - Renumber the spike_processing no-spike-accumulation finding to F6 (the
    parallel gap-module agent claimed F4/F5 for two real hu_compute bugs).
    - F6 documented in FINDINGS.md; tb_spike_processing NOTE label updated.
    [tb_spike_processing.v]
2026-06-07 scheduler: aggressive sub-module tests + fix 3 stale .bsh
    Cycle-accurate SW reference models for buffer_state_entry, sch_buffer_state,
    acc_hw_buffer_tracker, sch_entry, sch_table (~120k random checks total,
    mirroring the RTL priority chains). Repairs myBuffState/myProgCache/mySchProg
    (missing restore tcl, bad constants path, archived tb). scheduler suite now 9/9.
    No scheduler RTL bugs found.
    [tb_acc_hw_buffer_tracker.v, tb_buffer_state_entry.v, tb_sch_buffer_state.v, tb_sch_entry.v, tb_sch_table.v]
2026-06-07 snnAcc: aggressive datapath utility tests (incl. first-ever packer test)
    packer (NEW, 8135 chk), slice_and_align (64008), dataline_cache (5895),
    syn_curr_update (1408), act_index_generator (2250), weight_generator (88).
    SW goldens mirror the RTL bit placement / addressing. Design notes D1-D3 in
    verif/FINDINGS.md (packer write-while-full, finished_pass pulse timing, cache
    slice-size aliasing) — latent constraints, not live bugs.
    [tb_act_index_generator.v, tb_dataline_cache_with_xy.v, tb_packer.v, tb_slice_and_align.v, tb_syn_curr_update.v, tb_weight_generator.v]
2026-06-07 shared+Hadamard: first-ever unit tests for bram/pool/hu modules
    bram_sp/sdp/tdp (read-first, ~16k chk), shared_pool (66077 chk, full arbiter
    replica), hu_compute (20045), hu_config_regs (62). Surfaced F4+F5: real
    hu_compute wide-Z multiply bugs (only top byte of Z used; accumulator-shift
    precedence) — must fix together; tb_hadamard_unit only tested 8-bit so never
    caught them. BRAM/pool/config modules are clean.
    [tb_bram_sdp.v, tb_bram_sp.v, tb_bram_tdp.v, tb_hu_compute.v, tb_hu_config_regs.v, tb_shared_pool.v]
2026-06-07 annAcc: fix tb_spike_processing module name (spike_processing -> ann_spike_processing)
    Stale after the annAcc ann_ module rename: the tb instantiated the old name and
    failed elaboration in the baseline. One-line fix; test now PASSES. (A full
    aggressive port of the annAcc spike test remains deferred Phase-4 work.)
    [tb_spike_processing.v]
2026-06-07 fix(F1): signed decay multiply in snnAcc/ipSnnAcc/annAcc update_state
    The Q0.32 decay was `mul_a * mul_b` with mul_b unsigned, so Verilog evaluated
    the whole multiply unsigned and corrupted decay of NEGATIVE operands
    (decay(-1000, 0.5) gave +2.1e9 instead of -500). Applied the fmiSnnAcc form
    $signed(mul_a) * $signed({1'b0, mul_b}) in all three modules. Positive operands
    unchanged; fmiSnnAcc was already correct.
    Goldens np_ref_lif / np_ann_decay now use np_decay_signed; the directed
    negative-decay probe is now a HARD check. The saturation-quirk decayed value
    legitimately flips +2^30 -> -2^30 (signed decay of the clamped 0x80000000);
    test expectations updated accordingly.
    Verified PASS: snn/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
    [tb_np_ref_selftest.v, tb_update_state_for_neuron.v, update_state_for_neuron.v]
2026-06-07 fix(F4/F5): correct hu_compute Hadamard datapath (Z multiply was discarded)
    F4/F5 turned out to sit on a deeper scaling bug: the Z operand was never
    aligned to the internal binary point (HALF=24) like A/B, so Z*(A-B) landed at
    bp_z+24 while B/R_prev were added at 48 and out_shift assumed 48 -- the multiply
    term was truncated away. hu_compute effectively output B(+R_prev), ignoring
    Z*(A-B) (directed Z=2,A=5,B=1 gave R=1 not 9). The old unit test passed only as
    a characterisation model; tb_hadamard_unit only used Z=0/A=B cases.
    hu_compute.v:
    - F4: chunk the right-aligned integer z_val LSB-first; top chunk signed, lower
    chunks unsigned (exact two's-complement z_val*amb).
    - F5: shift the part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
    [hu_compute.v, tb_hu_compute.v]
2026-06-08 verif: close named-module gaps (annAcc/fmiSnnAcc neuron_processing, Hadamard integration)
    Three aggressive golden-checked tests, all green:
    - annAcc/tb_neuron_processing (upgrade): whole-layer random vs np_ann
    threshold/requant/decay; RELU/LUT/ABS, requant on/off, 8/16/32-bit packing,
    back-pressure. 336 checks, 0 failures.
    - fmiSnnAcc/tb_neuron_processing (NEW; had no unit test): whole-layer random vs
    np_ref_fmi, plain (has_ada=0) AND adaptive (has_ada=1) paths + ada writeback,
    spike-word boundary, back-pressure. 793 checks, 0 failures (32-bit path).
    - Hadamard/tb_hadamard_unit (extend): real end-to-end multiply golden
    (R=Z*(A-B)+B+mode*R_prev), directed true-value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
    [tb_hadamard_unit.v, tb_neuron_processing.v]
2026-06-08 tools: add unified flexman_backend + tests
    Hardware-defined, torch-free deployment back-end (ISA assembler, AXI register
    maps incl. Hadamard, fixed-point packers + bias-fold, emitters, SharedPool, LUT
    generation) versioned alongside the RTL it tracks. tests/ run under bare python3;
    test_regmap_vs_rtl.py parses the .v config decoders to prevent offset drift.
    .gitignore: allow tools/ .py + .toml (repo is otherwise hardware-only).
2026-06-08 tools: add cfgmem packer (config_manager per-task config)
    Packs the 16-word cfg_mem stream config_manager pushes to an accelerator on
    TASK dispatch. Word i -> register offset i*4 (siren_detector_top glue
    cfg_cnt_N<<2); only offsets 0x00-0x3C are per-task reconfigurable. Per-task
    registers are reachable via the RTL's in-window aliases: word4 packs
    {np_mode,skip_neuron} (snn/ipsnn) or skip_neuron (ann); decays alias to
    words 6/7. Verified against the snnAcc/ipsnn/ann config decoders.
2026-06-08 fmiSnnAcc: implement bin_point_syn_curr scale shift
    The bin_point_syn_curr AXI register was wired into neuron_processing
    but never applied. With the FMI model's slow synaptic decays
    (dcy_syn up to 0.9998) and conv weights up to |w|=5.5, a single 32-bit
    syn_curr accumulator caps usable weight precision at K=9 fractional
    bits — far too coarse.
    Split into two scales bridged by the shift:
    - K_mem fractional bits in memory (weights + syn_curr stored here)
    - K_neuron = K_mem - bin_point_syn_curr for neuron dynamics
    neuron_processing.v now arithmetic-right-shifts syn_curr_data_out
    before update_state_for_neuron and arithmetic-left-shifts
    updated_syn_curr before the writeback packer. update_stat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
2026-06-11 tools: packed per-task config layout (PACKED_*, cfgmem packer, anti-drift tests)
    regmap.py: single-source-of-truth packed layout — 9 full-width address/decay
    words, S0-S3 (two 16-bit size lanes each), M0-M1 (bit-packed slice sizes and
    modes, 1-2 spare bits per field), BOOT_REG_OFFSETS for the out-of-window
    conv/sparse registers, THRESH_OP_* constants. The legacy scattered
    SNN/ANN_REG_OFFSETS maps are deleted — the RTL no longer decodes them.
    cfgmem.py: pack_cfg_words emits the packed words uniformly for all three
    accelerator variants (absent fields pack as 0); stride stays 16 (power-of-2
    config_manager addressing), word 15 spare.
    test_regmap_vs_rtl.py rewritten: parses the packed case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
2026-06-11 accs: packed per-task config decode (snnAcc, annAcc, ipSnnAcc)
    Replace the scattered per-register AXI decode with the packed 15-word layout
    (regmap.PACKED_*: word i at offset i*4). A multi-layer accelerator (snnAcc
    running recurrent pass1/pass2/readout) now gets its full per-task config —
    grid sizes, rows_per_neuron, bin points, modes — on every dispatch instead
    of boot-set-and-held values. Conv/sparse boot registers keep their >=0x5C
    offsets. Old scattered offsets removed (mirrored by the anti-drift test).
    [acc_snn_processor.v]
2026-06-11 tb: rewrite config sequences to the packed layout
    Unit TBs (snnAcc/annAcc tb_acc_snn_processor, annAcc tb_fe_addr_probe) and
    the top smoke TB (tb_siren_detector_top T3-T6a) now write the packed words
    0x00-0x38; mid-test register tweaks become single-word rewrites (addresses)
    or full M0/M1 rewrites (thresh_op, skip/np_mode). The smoke TB's cfg_mem
    images move from the old in-window alias layout to packed (T5/T6a prove
    per-task M1 mode and W7/W8 decay rotation through the config_manager).
    snnAcc TB also gains Test 4 — LAST input non-spiking — the regression for
    the weight-pass termination hang (see the e2e bug-chain commit).
    [tb_acc_snn_processor.v, tb_fe_addr_probe.v]
2026-06-11 accs+scheduler: fix the six RTL bugs blocking the closed-loop e2e
    Found by Stage-D debugging of tb_siren_e2e against the bit-accurate emulator
    golden (packed config delivery verified register-exact first — every bug
    below is RTL, not configuration). With all six fixed plus the two toolchain
    fixes (Bosch repo), the e2e passes 8 frames bit-exact.
    1. weight_generator (both copies): pass termination required seeing
    act_data_last_i on a VALID token, but the parents gate non-spiking /
    zero activations out of the wg act stream — a silent LAST input meant
    the pass never finished (deterministic snn0 hang: frame-0 encoder
    spike 63 is silent). New act_last_dumped_i port, driven by all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
    [dataline_cache_with_xy.v, neuron_processing.v, scheduler.v, spike_processing.v, syn_curr_update.v, tb_dataline_cache_with_xy.v, weight_generator.v]
2026-06-11 ipSnnAcc: sync six-bug fixes + packed config decode from the fixed copies
    The 2026-06-11 fix campaign (4b64bb9, 2b732a6) landed in snnAcc/annAcc and
    the siren_detector ipsnn_* copies but never reached this directory. Sync:
    - weight_generator.v / dataline_cache_with_xy.v: verbatim snnAcc copies
    (act_last_dumped_i hang fix, act_data_valid_i MAC gate, invalidate_i,
    slice_data_idx_o whole-index fix)
    - spike_processing / neuron_processing / syn_curr_update /
    update_state_for_neuron / acc_snn_processor: from the siren ipsnn copies
    with module names un-prefixed (act_last_dumped generation, cache
    invalidation on dispatch, stop-before-restart mux, 3-cycle 200 MHz USN
    pipeline, packed 15-w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
    [acc_snn_processor.v, dataline_cache_with_xy.v, neuron_processing.v, spike_processing.v, syn_curr_update.v, tb_acc_snn_processor.v, tb_dataline_cache_with_xy.v, tb_weight_generator.v]
2026-06-11 fmiSnnAcc: port the e2e bug fixes from snnAcc
    - spike_processing.v: generate act_last_dumped for a gated-out last
    non-spike, take non-spikes out of the act cache, invalidate the act
    cache on dispatch
    - syn_curr_update.v: stop conditions take priority over the restart term
    (infinite-restart fix)
    - neuron_processing.v: invalidate all nine fetch caches on task dispatch
    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
    [dataline_cache_with_xy.v, neuron_processing.v, spike_processing.v, syn_curr_update.v, weight_generator.v]
2026-06-11 snnAcc: fix stale slice_data_idx expectations in the cache unit TB
    The FE weight-addressing fix changed slice_data_idx_o to return the whole
    element index (= sys_addr_i) instead of the within-word offset; the unit
    TB still expected the offset (pre-existing failures noted 2026-06-10).
    5895 checks, 0 failures.
    [tb_dataline_cache_with_xy.v]
2026-06-11 gitignore the staged siren e2e sim copies
    sim_siren_e2e.bsh copies cfg_mem.vh / static_config.vh from the Bosch
    artifacts into siren_detector/ on every run; ignore them past the !*.vh
    allow rule.
2026-06-12 emulate: add LUT activation + Hadamard + width-param MAC (additive)
    Generic backend primitives modelling the annAcc LUT activation path and the
    Hadamard datapath:
    - Lut: sigmoid/tanh activation tables with a structural scaled+saturated
    index (cut-offs derived from table size N and input scale F) and a
    signed-output path for tanh
    - hadamard: R = Z(A-B)+B (element-wise gated update; plain product when B=0)
    - mac_accumulate/mac_signed: optional `bits` accumulator width
    (default 32 = syn_curr as built; widened only by precision studies)
    Additive and unused by the existing spiking-network path; all 47 backend
    tests still pass.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
2026-06-13 annAcc §5.1/§5.2: default-off windowed LUT index + signed-tanh output
    Completes the annAcc LUT activation path for the NsNet2 sigmoid/tanh gates,
    on top of §5.4 (signed-activation MAC). Two more spare-M0 default-off mode
    bits, no new config register; the LUT path is dormant today (no net uses LUT
    mode — Bosch uses ABS) so this stays bit-identical until opted in.
    §5.1 (np_lut_window, M0[29]) — neuron_processing.v: when set, the LUT index is
    clamp(($signed(syn_curr) >>> (bin_point_syn_curr - F)) + MID, 0, N-1),
    reusing bin_point_syn_curr (no new register); F = LUT_IDX_SZ-3 localparam,
    MID = N/2, saturation detected on the full width before truncation so a large
    |pre-activation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
2026-06-14 fpga wrapper: re-point onto the shared 4-bank data pool (fix elab drift)
    flexman.v moved all act/syn_curr/spike memories and the four Hadamard
    buffers out of per-accelerator ports into one 4-bank shared pool
    (m0..m3_data_mem_*). flexman_fpga_wrap.v still wired the removed
    s0/s1/a0_act/syn_curr/spike_mem_* and hd_src_{a,b,z,r}_mem_* ports, so
    elab_fpga_wrap failed with 87 *E,CUVPOM port errors. Re-point the wrapper:
    - Drop the stale per-acc act/syn_curr/spike + Hadamard wires, u_flexman
    connections, and BRAM instances.
    - Add the 4 pool banks: m0..m3_data_mem_* wires, u_flexman connections
    (wait_i tied low), and four bram_sp 32-bit banks (single R/W port each,
    matching the shared_pool c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
    [flexman_fpga_wrap.v]
2026-06-14 flexman: add POOL_RD_BASE host pool-readback window (Plan B)
    Memory-mapped, read-only AXI window so the host can read the shared
    4-bank pool back out (e.g. output activations after a run), replacing
    the per-accelerator spike readback ports dropped in the pool-drift fix.
    - New POOL_RD_BASE param (default 0x1010_0000), decoded on
    sys_addr_i[31:20] -> 1 MB / 256K-word window, clear of the accel
    config windows (0x100x) and CM/BBA/FU/SCH ranges.
    - One new shared_pool requester at index SP_NREQ-1 (lowest priority),
    so readback never disturbs compute -- it just waits for a free bank
    cycle. SP_NREQ 15 -> 16; existing requester indices unchanged.
    - Small read FSM (IDLE/REQ/CAP/ACK): issues o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
    [flexman.v, tb_flexman.v]
2026-06-15 fmiSnnAccMC tb: sticky-flag latch fixes wait_pipeline race for sp_skip_neuron=1
    T8 in fmiSnnAccMC exposed a long-standing harness limitation: the RTL
    fires spike_proc_finished_o and acc_finished_o as 1-cycle pulses (this
    is a deliberate convention -- the scheduler OR-latches them at
    sch_buffer_state.v:103-104 so it doesn't need them sustained). The
    testbench wait_pipeline task, however, polls them across an intermediate
    @(posedge clk), which loses the pulse whenever the two signals are the
    SAME wire -- which happens exactly when sp_skip_neuron=1 in M0 makes
    acc_finished_o forward sp_acc_finished directly (acc_fmiSnnMC_processor.v:390).
    Fix is testbench-only. Two new sticky-flag registers
    sp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
    [tb_acc_fmiSnnMC_processor.v]
2026-06-15 fix(F7): correct hadamard_unit multi-word / 32-bit output addressing
    hadamard_unit fed the output packer the cache's PER-WORD slice index
    (a_idx, resets every 32-bit input word) instead of the GLOBAL stream
    position. The packer derives the output word address from that index
    (offset = index >> (5-out_sz)), so (a) any stream spanning >1 output word
    wrote every word to base+0 (only the last survived) and (b) 32-bit
    elements emitted an X address (dataline_cache_with_xy.slice_idx had no
    'b101 case). Latent since the initial monorepo commit -- never triggered
    because the Hadamard block had never been driven with a real multi-word
    stream. Blocks any multi-element gated-update task.
    Fix (reuse the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
    [dataline_cache_with_xy.v, hadamard_unit.v, stream_generator.v, tb_hadamard_unit.v]
2026-06-15 feat(§5.3): emit_lut_image — pack activation LUT tables into a thresh_mem .hex
    Adds the missing glue for the annAcc LUT load path (np_thresh_op=LUT): a
    generic emitter that packs one or more flat int16 activation tables (sigmoid,
    tanh) into a single $readmemh thresh_mem image, laid out at ascending 32-bit
    word bases (each base is the np_thresh_base for the gate task using that table).
    Reuses pack_table (2 entries/word, LSB-first, two's-complement masked) and
    write_hex; returns the per-table bases. Back-end mechanics only — the front-end
    chooses which functions/scales (keeps app specifics out of the backend).
    tests: round-trip (emit -> read -> unpack == source) + base layout, and that
    t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
2026-06-15 fix(hadamard cfg): one register per 32-bit word so the config_manager can deliver it
    hu_config_regs decoded reg_sel = addr[7:0] as a unit-stride register index
    (mode@0x00, stream_len@0x01, A base/elem_sz/bin_point@0x04/05/06, ...), which
    only the behavioural unit-TB could drive. The config_manager streams per-task
    config as word i -> byte i*4 (HAD_CFG_BASE | cfg_cnt<<2), i.e. reg_sel on the
    multiples-of-4 grid only — so stream_len and every elem_sz/bin_point (off-grid)
    were structurally unreachable, and the Hadamard could not be configured per task.
    Latent because no shipped config ever drove the Hadamard via the config_manager
    (siren/Bosch don't use it); it surfaces now that the GRU needs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
    [hu_config_regs.v, tb_hadamard_unit.v, tb_hu_config_regs.v]
2026-06-16 annAcc §5.5: default-off per-neuron bias accumulator-seed channel
    The annAcc bias port was tied off and np_bias_curr_sz repurposed as
    lut_out_sz, so the GRU per-neuron biases (b_rz, b_hn, b_in) had no home.
    Add a real bias input channel with its own binary point (a colleague's
    weight/bias scaling analysis: biases want a distinct shift from the
    weights), seeded into syn_curr BEFORE the MAC so it composes with a
    FILL-zeroed accumulator AND a Hadamard-seeded one (GRU candidate n =
    r*c_n + b_in), and works on skip passes (GRU c_n) where neuron_processing
    never runs.
    Mechanism (acc_snn_processor.v only — syn_curr_update MAC and
    neuron_processing untouched): a small PL_RD/PL_LAT/PL_WB preload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
    [acc_snn_processor.v, tb_acc_snn_processor.v]
2026-06-17 GRU bring-up: round-robin pool arbiter + 3 latent-bug fixes exposed by it
    First end-to-end run of the NsNet2 GRU layer through flexman.v surfaced four
    issues on paths the annAcc + Hadamard exercise through the shared pool for the
    first time (siren used snnAcc/ipsnn only):
    - shared_pool.v: add per-bank round-robin arbitration (param ARB_RR, default 0 =
    strict = bit-identical baseline; STRICT == RR with the pointer frozen at
    NUM_REQ-1). flexman.v sets ARB_RR(1) on u_pool. Fixes the annAcc act/syn-curr
    same-bank starvation deadlock (strict priority starved the lower-index port
    while the accelerator stalled holding both).
    - fill_unit.v: hold shared_data_wr_o stable under back-pressure.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
    [fill_unit.v, flexman.v, shared_pool.v, stream_generator.v]
2026-06-17 GRU bring-up: fix two annAcc/Hadamard latent bugs (GRU now bit-exact e2e)
    Two RTL bugs surfaced by the first real annAcc dense + Hadamard mixed-size
    run (NsNet2 single-GRU e2e, 400-wide). Both default-affect only the GRU
    path; snnAcc/ipSnnAcc and existing tasks are bit-identical.
    1. annAcc weight-index overflow (flexman.v u_ann SP_WEIGHT_IDX_SZ 5 -> 16).
    weight_generator's output-element index (out_elem_count, which drives the
    weight-cache word/slice address) is WEIGHT_IDX_SZ-wide; the default 5 bits
    wrap at 2^5=32, so for 400 output neurons every block of 32 re-read the
    first 8 weight words. Frame-0 gate R was bit-exact for o<32, diverged for
    o>=32. Widened to match SP_X_OUT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
    [flexman.v, stream_generator.v]
2026-06-17 Hadamard: drop stale local dataline_cache_with_xy, use the snnAcc canonical copy
    Hadamard kept its own copy of dataline_cache_with_xy.v that had drifted from the
    shared cache: it never received the closed-loop six-bug fixes (commit 6641ced,
    which added invalidate_i + the barrel-shift index + base-addr tracking +
    slice_data_idx_o=sys_addr_i to the annAcc/ and snnAcc/ copies but not this one).
    Once stream_generator started driving .invalidate_i (0c0036e) the local copy —
    lacking that port — broke tbHadamard.bsh elaboration. The integrated design was
    unaffected because flexman.v / the e2e compile the snnAcc copy for the Hadamard
    streams.
    Delete the local copy and point tbHadamard.bsh at ..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
    [dataline_cache_with_xy.v]
2026-06-17 fix(tb_fill_unit): count held write-request gated by ~wait (T4)
    The fill_unit comb-loop fix holds shared_data_wr_o HIGH throughout ST_FILLING
    (it holds the write REQUEST; actual write advances on do_write = ST_FILLING &
    ~selected_wait). The TB's write detector counted shared_data_wr_o directly, so a
    stalled FILL (shared_data_wait_i=1) was mis-counted as writes -> T4 failed
    ('write count advanced during wait', final 12 vs 8).
    Gate the TB's shared-data write detection by ~shared_data_wait_i (new
    shared_data_wr_eff), matching how every other bus is already do_write-gated.
    Test-only; no RTL change. tb_fill_unit now 0 failures (T4 PASS).
    [tb_fill_unit.v]
2026-06-18 fpga: add bram_dist/bram_sdp_uram primitives, guard ADDR_SIZE, fix generic-wrap prog
    - shared/bram_dist.v: distributed-RAM (combinational read) primitive.
    - shared/bram_sdp_uram.v: ram_style=ultra variant for deep weight stores.
    - shared/constants.v: guard ADDR_SIZE (`ifndef, default 30) so a build can
    +define+ADDR_SIZE=N without editing the file. Behavior-neutral.
    - top_module/flexman_fpga_wrap.v: prog mem bram_sdp -> bram_dist (combinational
    read) — the scheduler instruction fetch assumes 0-cycle prog under wait=0 and
    double-fires NXT with a 1-cycle BRAM. elab_fpga_wrap clean.
    Recovered from tag bosch-fpga-wrap-snapshot; no accelerator-datapath RTL changed.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
    [bram_dist.v, bram_sdp_uram.v, constants.v, flexman_fpga_wrap.v]
2026-06-20 fix(tb_flexman): re-pack T3 snnAcc config to the 08211ba packed layout
    T3 (inter-accelerator pool dataflow) failed: snn0 dispatched but never
    finished, so snn1's producer/consumer dependency never cleared (pool[8]=0).
    Root cause: stale TEST, not an RTL bug. Commit 08211ba ("packed per-task
    config decode") moved the snnAcc config into a packed 15-word window (word i ->
    offset i*4: W0-W8 bases/decay, S0-S3 sizes, M0/M1 mode/slice). T3's cfg_mem[]
    was still filled with the OLD scattered-offset field order, so its words landed
    in the wrong packed registers -- word 9 (rsvd=0) -> S0 => in_x=in_y=0, which
    makes act_index_generator never assert 'last', so spike_processing spins
    forever. (cfg_snn_st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
    [tb_flexman.v]
2026-06-20 snnAcc: add traceability-only SNN_ACC_VERSION build tag
    Add a purely-informational module version tag to snnAcc acc_snn_processor for
    build traceability. Zero functional impact: read by no RTL logic, no flops, no paths.
    - shared/constants.v: guarded `define SNN_ACC_VERSION 32'h2026_0620 (YYYYMMDD).
    - snnAcc/acc_snn_processor.v: module's first localparam, sourced from the define.
    - snnAcc/tb_acc_snn_processor.v: $display + soft non-zero guard (no bare PASS/FAIL).
    Scope: snnAcc/ copy only (annAcc/, ipSnnAcc/ untouched). Headers left in repo
    SPDX+Copyright style. AXI config-read exposure deferred.
    Verification: snnAcc block regression PASS (10/10). Full regression 56/57 PASS;
    the lone failur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
    [acc_snn_processor.v, constants.v, tb_acc_snn_processor.v]
2026-06-21 fix(neuron_processing): F8 — strobe writeback packers on result_taken, not held result_valid
    All five neuron_processing variants drove the writeback packers
    .pak_write_i(result_valid). result_valid is a LEVEL held high whenever any
    packer is back-pressured (result_taken = result_valid & ~packer_full & ~*_wb_full),
    so the OR-accumulating packer.v double-accumulated under sustained writeback
    memory back-pressure:
    (a) sub-32-bit: merged the NEXT neuron's field into a not-yet-flushed word; and
    (b) the 1-bit spike packer / 32-bit packers: re-accumulated + re-flushed a word
    already flushed, overwriting it (hits even all-32-bit configs, e.g. FMI).
    Unreachable before because every tb ha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
    [neuron_processing.v, packer.v, tb_neuron_processing.v, tb_packer_cadence.v]
2026-06-22 fmiSnnAccMC: fix conv downsampling projection + FMI-scale T9; parameterise neuron-index width
    Two RTL fixes that make the FMI stride-2 conv layers compute correctly at
    full scale, validated bit-exact against a PyTorch golden.
    1. Conv spatial projection (weight_generator.v). The old
    out = act*step + k - offset is an input-UPSAMPLING (transposed-conv)
    scatter: correct only at stride=1, and kernel-flipped vs PyTorch. FMI
    inter-group convs DOWNSAMPLE (group3 120 -> group4 60, stride 2). Replaced
    with out = (act + offset - k) / step (power-of-2 stride via right shift,
    plus a divisibility skip folded into oob_skip) = exact PyTorch strided
    cross-correlation. T8 expected values up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
    [acc_fmiSnnMC_processor.v, act_index_generator.v, neuron_processing.v, packer.v, syn_curr_update.v, tb_acc_fmiSnnMC_processor.v, weight_generator.v]
2026-06-22 shared: consolidate identical primitives slice_and_align.v + sram_bram.v
    First step of the primitive-consolidation refactor (plan: shared-library
    consolidation + bus-width parameterisation). slice_and_align.v (6 copies) and
    sram_bram.v (5 copies) were byte-identical across all blocks (md5-verified), so
    move one canonical copy of each into shared/, repoint every build script to
    ../shared/, and delete the per-block duplicates.
    No logic change. Full regression 59/59 PASS, bit-identical to the pre-change
    baseline. (Fixed one self-inflicted issue: the initial sed repoint matched
    slice_and_align.v as a substring of tb_slice_and_align.v; corrected.)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
    [slice_and_align.v, sram_bram.v]
2026-06-22 shared: consolidate dataline_cache_with_xy.v
    Move the canonical snnAcc copy (the F7-correct one already referenced by
    Hadamard and the top-level builds) into shared/, repoint all build scripts to
    ../shared/, and delete the 4 per-block duplicates (snnAcc/ipSnnAcc/fmiSnnAcc/
    fmiSnnAccMC identical; annAcc differed only in a comment/provenance note).
    No logic change. Full regression 59/59 PASS, bit-identical to baseline.
    [dataline_cache_with_xy.v]
2026-06-22 top_module: add example_app_top.v — worked example of per-instance bus sizing
    A complete, ELABORATING demonstrator of the FlexMan sizing discipline: the top
    level is the single place each accelerator instance's data/address/index buses
    are sized for its largest layer, via parameter overrides. Derived from
    flexman.v (so the full scheduler/config_manager/shared_pool/fill_unit/memory
    fabric is correct by construction).
    A "PER-APPLICATION BUS SIZING" block derives index widths from neuron counts
    ($clog2). u_snn0 is sized for a 1920-neuron RECURRENT layer (REC_IDX_SZ=11),
    exceeding the legacy `PIN_BITS=10 (1024) cap purely by overriding
    NP_NEURON_IDX_SZ / SP_ACT_IDX_SZ / *_IDX_SZ — so elabor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
    [example_app_top.v]
2026-06-23 fmiSnnAccMC: promote cin_len/cout_len from POC wires to the S2 config word
    Multi-channel sizing (sp_cin_len/sp_cout_len) was driven by top-level testbench
    wires (POC). Promote it into the PACKED_FMI per-task config so the scheduler /
    config_manager can program it — a prerequisite for wiring fmiSnnAccMC into a
    real top. They are decoded from the S2 word (0x38) high lane: cin_len at bit 16
    (+:SP_CIN_SZ), cout_len at bit 24 (+:SP_COUT_SZ); total_timesteps stays in [9:0].
    Registers reset to 1 (legacy single-channel collapse).
    - acc_fmiSnnMC_processor.v: drop the sp_cin_len_i/sp_cout_len_i input ports; add
    sp_cin_len_r/sp_cout_len_r decoded in the S2 case; feed spike_processing from them.
    -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
    [acc_fmiSnnMC_processor.v, tb_acc_fmiSnnMC_processor.v]
2026-06-23 fmi_top: Stage B — dedicated elaborating FMI top (1x fmiSnnAccMC)
    Wire the multi-channel recurrent SNN accelerator (acc_fmiSnnMC_processor,
    1920 neurons, <=64 channels, 120->60 conv) into the proven FlexMan fabric:
    scheduler + config_manager + shared_pool + 1x acc_fmiSnnMC_processor.
    Derived from example_app_top.v but stripped to ONE compute accelerator:
    no snn1/ann/hadamard, and (this round) no fill_unit. The accelerator is sized
    to the bit-exact T9-validated parameter set from tb_acc_fmiSnnMC_processor.v.
    - NUM_HW_ACCELERATORS=2: compute=acc0 (u_fmi) + reserved fill slot=acc1
    (FILL_ACC_ID), tied off (no fill_unit; its write ports are hardcoded to the
    snn/ann/hadamard memory set —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
2026-06-23 fmi_top: Stage C / C1 — scheduler-driven top-level integration tb (T9 reproduction)
    tb_fmi_top.v drives the FMI multi-channel recurrent accelerator THROUGH THE FULL
    fabric (scheduler -> config_manager -> shared_pool) and reproduces the bit-exact
    T9 golden (con2 feed-forward group3->group4, one timestep) that the block-level
    tb_acc_fmiSnnMC_processor T9 already passes. New coverage = the integration, not
    new golden arithmetic. TB-ONLY: no RTL change.
    - Step 0 finding: fmiSnnMC's sp_*/np_*_buff_addr ports are dead ("unused, kept for
    scheduler compatibility") -> all addressing is via the config base words. So
    fmi_top's snn0-cloned BBA fan-out is harmless, and act/syn_curr/spike share the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
2026-06-23 docs(FINDINGS): mark F6 and F3 RESOLVED
    F6 (full-mode spike gating) — settled as a real correctness bug (zero
    activations gave syn=nin*w, not 0), fixed by the 2026-06-10 act-gate rework;
    snnAcc no-spike probe now suppresses (syn=0, 820/0), gating identical across
    all five variants. Not a performance issue.
    F3 (flexman_fpga_wrap out of sync) — wrapper re-synced to flexman.v's reworked
    memory interface; elab_fpga_wrap.bsh now elaborates clean (exit 0, 0 errors),
    run_regression scores it PASS(elab).
    Doc-only; no RTL change.
2026-06-24 isa: widen TASK cfg_id field 5->7 bits (128 configs), across-the-board
    The 5-bit cfg_id field [9:5] of TASK word 1 capped programs at 32 configs,
    which blocks a multi-accelerator output-partition use case (needs 16N+4 cfg_ids:
    N=2=36, N=3=52). Clean uniform widen to a 7-bit field [11:5]; colour and the
    three short slots shift up by 2 (slot2 buf_id now tops at bit 30, still inside
    the 32-bit word).
    - isa.py tw1: cfg [11:5] (mask 0x7F, assert <128); colour [12]; slots shifted.
    - scheduler.v: CFG_ID_SZ default 5->7; re-slice all task_w1_r field extracts;
    entry grows 54->56 bits via existing derivations.
    - All app tops (flexman / flexman_fpga_wrap / example_app_top / fmi_top):
    CFG_ID_SZ 5->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
    [example_app_top.v, flexman.v, flexman_fpga_wrap.v, fmi_top.v, scheduler.v, tb_flexman.v, tb_fmi_top.v]
2026-06-24 test(ipsnn_drift): align with shared/ hoist + sync act_index_generator drift
    The 2026-06 refactor hoisted dataline_cache_with_xy/packer/slice_and_align/
    sram_bram.v from snnAcc/ into a single shared/ copy. test_ipsnn_drift still
    referenced snnAcc/ for those, so it FileNotFound'd (and its FailFast masked a
    real drift in the remaining per-variant files).
    - Drop the hoisted files from the byte-identity check (single canonical copy now
    => nothing to drift) and add test_hoisted_modules_are_single_copy_in_shared
    to enforce shared/-only + catch future re-duplication.
    - Keep the byte-identity check for the still-duplicated weight_generator.v /
    act_index_generator.v vs the snnAcc/ reference.
    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
    [act_index_generator.v]
2026-06-24 isa: widen TASK/FILL usage-count (ntgt) field 3->4 bits, across-the-board
    The 3-bit #Targets/usage field [max 7] capped how many consumers a buffer could
    have. A multi-accelerator output-partition shares one recurrent state across N
    lanes, where it is read by 6N+1 consumers (13 at N=2) -- over the old limit.
    Clean uniform widen of TGT_COUNT_SZ 3->4 (max 15), the natural ceiling: three
    long slots x (2+4+4) + 2-bit sentinel pack TASK word 2 exactly to bit 31 (5-bit
    would need 33 bits). FILL ntgt -> [12:9], block_size -> [31:13] (19-bit).
    - isa.py: tw2 repack (n3/n4/n5 4-bit), fill_w1 ntgt mask 0xF + block_size shift.
    - scheduler.v: TGT_COUNT_SZ default 3->4; re-slice task_w2 long-slot extrac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
2026-06-25 annAcc: latch syn_curr accumulator read for back-pressure-safe write-back
    The accumulator write-back (syn_curr_mem_data_o = syn_curr_mem_data_i + product)
    was combinational off the LIVE shared-pool read-return, which is valid for only
    one cycle after the read grant. Under heavy pool contention (multiple compute
    accelerators), a back-pressure-delayed write-back could sample a value clobbered
    by another requester reading the same bank, committing a wrong accumulator and
    scrambling the dense-layer output.
    Latch the read value on the first write-back cycle (when it is valid) and use the
    latched copy on any stalled retry. Bit-identical when uncontended; full RTL
    regression 62/62 unchanged.
    Co-A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
    [syn_curr_update.v]
2026-06-25 scheduler: keep FILL block_size/value valid until launch (one FILL in flight)
    A FILL's buffer-id travels with the launched table entry, but its block_size and
    fill value live in single registers that the NEXT FILL's word-1 overwrites. With
    FILLs issued back-to-back and a launch delayed by a busy fill_unit (shared-pool
    contention), a FILL could dispatch with the correct buffer-id but a LATER FILL's
    block_size/value — e.g. a small per-lane accumulator fill picking up a following
    larger fill's size and overrunning the adjacent live buffer.
    Gate the next FILL's word-1 decode until the in-flight FILL has launched, so its
    block_size/value stay valid at dispatch. The gate makes load and launch m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
    [scheduler.v]
2026-06-25 snnAcc: latch syn_curr accumulator read for back-pressure-safe write-back
    Port of the annAcc fix (c25b7b0) to the snnAcc variant. The write-back
    syn_curr_mem_data_o = base_syn_curr + aligned_weight_value took the previous
    accumulator off the live pool read-return (base_syn_curr = syn_curr_mem_data_i),
    valid only one cycle after the read grant; a back-pressure-stalled write-back
    could sample a value clobbered by another requester on the same bank. Latch the
    read value on the first write-back cycle, use the latched copy on a stalled
    retry. Bit-identical when uncontended; full RTL regression 62/62 unchanged.
    [syn_curr_update.v]
2026-06-25 snnAcc variants: latch syn_curr accumulator read (ipSnnAcc/fmiSnnAcc/fmiSnnAccMC)
    Port of the annAcc/snnAcc fix (c25b7b0/572f27b) to the remaining three
    syn_curr_update.v variants. Each had the identical latent bug: the write-back
    base_syn_curr = syn_curr_mem_data_i reads the LIVE pool read-return (valid one
    cycle after the read grant), so a back-pressure-stalled write-back could sample a
    value clobbered by another requester on the same bank. Latch the read value on
    the first write-back cycle; use the latched copy on a stalled retry. Bit-identical
    when uncontended; full RTL regression 62/62 + variant parity (test_ipsnn_drift)
    unchanged. Closes the bug across all five syn_curr_update.v copies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
    [syn_curr_update.v]
2026-06-27 fmi_top: Stage C2a -- scheduler hardware-loop tb (group4 con2 feed-forward over T)
    Drives the scheduler LOOP/NXT/LOOPEND over T timesteps, one con2 feed-forward dispatch per timestep, with syn_curr leaky-carry and pot carry handled by the accelerator across separate dispatches. Buffer choreography, no RTL change: SOURCE input re-fed + re-marked each iteration; output is READ-WRITE so it self-cycles full->busy->full with no consumer to free it (sch_entry.v:90 -- RW gates on full, not free). Lock-stepped so the next TASK cannot overwrite before the per-timestep check. Compares spike4 60/60 + syn4 1920/1920 every step vs fmi/gen_c2a_golden.py. PASS at committed T=8 and full T=249. Regression au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
    [tb_fmi_top_c2a.v]
2026-06-28 fmi_top: Stage C2b -- group4 con2 + con3 recurrence (single-buffer, 2 dispatches/timestep)
    tb_fmi_top_c2b.v drives the scheduler hardware loop with TWO dispatches per timestep: A = con2 feed-forward (cfg0, skip_neuron=1, conv-only accumulate, no decay), B = con3 recurrent (cfg1, skip_neuron=0) reading spike4[t-1] then the neuron writing spike4[t] to the SAME buffer. The recurrent buffer is READ-WRITE: spike_processing strictly precedes neuron_processing (acc_fmiSnnMC_processor.v:554), so con3 reads spike4[t-1] before the neuron overwrites it -- single buffer, no ping-pong, no colour. Per-config stride (S2) lets con2 (stride 2) and con3 (stride 1) coexist as two cfg_ids; con3 weights at weigh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
    [tb_fmi_top_c2b.v]
2026-06-28 fmi_top: C2b AXI-readback build -- drop -access wrc for fast full-T runs
    Reworks tb_fmi_top_c2b to use ZERO hierarchical .mem[] backdoor refs so the sim compiles without Xcelium -access wrc (which disables optimisation and dominated long runs). Result compare -> AXI reads via the host POOL_RD_BASE window (the path C1 cross-validated against the backdoor). Input load -> a tb-side write port mux'd over each pool bank's DUT write port (port connectivity, driven only in the per-timestep gate window while the DUT is idle). Dedicated mems -> $readmemh into the tb sram_models (verified NOT to need -access wrc). State zeroing -> sram_model init. fmi_top has only a host pool-READ window (no host pool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
    [tb_fmi_top_c2b.v]
2026-06-29 fmiSnnAccMC: add real-valued MAC front-end mode (con1 input layer)
    Adds a default-off real-valued-activation MAC mode so the FMI con1 input layer
    (real log-mel input -> adaptive-LIF encoder, group3) runs in hardware -- the one
    network layer with no prior HW implementation. con1 is a continuous fan-out, not
    a spike conv, so the spike-gated datapath could not represent it.
    Gated on M0[31]=sp_real_mac (default 0); legacy spike-conv paths byte-identical.
    In real-MAC mode spike_processing passes the full signed 32-bit activation value
    (vs a 1-bit spike) and syn_curr_update accumulates (weight*act)>>>mac_shift
    (signed MAC mirrored from annAcc; mac_shift @0x98 = K_MEM) instead of the
    spike-gated +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
2026-06-29 fmi_top: con1 real-MAC input layer on the fabric (scheduler loop)
    Runs the network's real-valued INPUT layer (con1 fan-out -> group3 adaptive-LIF
    encoder) through the full fmi_top fabric -- scheduler / config_manager /
    shared_pool -- one dispatch per timestep, the C2a hardware-loop applied to the
    new fmiSnnAccMC real-MAC mode. con1 runs as a cin=2 conv (channel0 = real log-mel
    input, channel1 = the Q-K constant one; weights [w,b]) so the bias folds in with
    no bias datapath.
    New coverage vs the block T10: the config_manager 16-word push carries M0[31]
    real_mac; the 0x98 mac_shift boot reg is delivered by direct host AXI; and
    shared_pool routes the REAL-valued (cin=2) activation. TB-only -- n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
2026-06-29 Add con6 LI readout: conv-datapath FC + readout-neuron mode (default-off)
    con6 (group6) is the network output: a non-spiking leaky-integrator readout,
    1920->1. Two new pieces on fmiSnnAccMC, both bit-exact at block level:
    - FC weighted sum (inj6) via the CONV datapath with a full-width kernel
    (cin=64, kernel=in_x=30, out_x=1) = the 1920->1 FC. SP_X_KERNEL_SZ 3->5
    (byte-identical for kernels <=7). T11: 12/12 inj6.
    - Readout neuron mode (M0[3]=np_mode[1], default-off): new_mem = dcy_mem*pot
    + syn, no threshold/reset, output wrapped pot; pot carries, syn fresh
    (dcy_syn=0). update_state_for_neuron + neuron_processing + processor.
    T12: 40/40 pot6.
    Native full mode (the first choice fo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
    [acc_fmiSnnMC_processor.v, fmi_top.v, neuron_processing.v, tb_acc_fmiSnnMC_processor.v, update_state_for_neuron.v, weight_generator.v]
2026-06-29 Add C2c Phase 1 tb: full g3->g6 on fmi_top, T=16 bit-exact
    Six dispatches/timestep (con1..con6) chained through the scheduler with
    intra-timestep producer->consumer buffer handoff:
    buf1 spike3: con1 TARGET -> con2 SOURCE (fresh feed-forward generation)
    buf2 spike4: con3 RW #t=2 -> con4 SOURCE (recurrent + feed-forward)
    buf3 spike5: con5 RW #t=2 -> con6 SOURCE (recurrent + feed-forward)
    Recurrent buffers carry #Targets=2 so the RW refull keeps them full for
    next-timestep recurrence while the one feed-forward consumer decrements to 1
    (verified vs buffer_state_entry.v; #t=1 would deadlock).
    Packed weights (con1@0..con6@38432, additive base) + per-group param slices
    (g3@0 g4@2048 g5@4096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
2026-06-29 C2c Phase 2: AXI-readback build, full T=249 bit-exact
    Convert tb_fmi_top_c2c.v to the no-wrc AXI-readback build (like C2b 32780d4):
    zero hierarchical .mem[] backdoor refs, so it compiles WITHOUT -access wrc.
    - input load : tb-side write port mux'd over each pool bank (240 words/t)
    - spike3/4/5 compare: AXI reads through the host POOL_RD_BASE window
    - pot6 compare : pot6 is in the dedicated pot_mem (not the pool, so POOL_RD
    can't reach it) -> a NEW tb-side pot_mem READ-port mux,
    sampled in the idle gate window
    - state zeroing : sram_model init-zero (no backdoor clear)
    Full T=249 VERIFIED: spike3/4/5 60/60 + pot6 bit-exact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
2026-06-29 Add sim_fmi_top_c2c.bsh: wire C2c into the regression runner
    run_regression.sh auto-discovers any *.bsh declaring xrun -top <module>, so this
    no-wrc AXI-readback run script (modeled on sim_fmi_top_c2b.bsh) brings the full
    g3->g6 C2c test into the suite. Verified: ./run_regression.sh c2c -> 1 passed.
    Suite total now 67. Committed tb runs T=16 (well within the 600s per-test limit);
    bump T_C2C to 249 for the full network pass.
2026-06-29 fmiSnnAccMC: drive readout_mode_i in 3 stale unit tbs (restore green)
    The con6 readout-neuron refactor (497c609) added input readout_mode_i to
    neuron_processing.v and update_state_for_neuron.v, but the isolated sub-module
    unit tbs were never migrated -> the new input floated to X -> 'got x' failures
    (tbNeuronProc, tbUpdateState, tbPackerCadence). The datapath was always correct
    (block-level tbAccFmiSNNMC + all fmi_top integration tests pass); only these
    standalone tbs lagged since 2026-06-29's readout commit.
    Drive .readout_mode_i(1'b0) (default-off plain/adaptive LIF) at each DUT
    instantiation -> existing LIF/adaptive vectors pass again. fmiSnnAccMC subset
    now 4/4. No RTL change.
    Co-Autho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
    [tb_neuron_processing.v, tb_packer_cadence.v, tb_update_state_for_neuron.v]
2026-06-30 snnAcc verification uplift: full-chip stress TB, packer-cadence, sparse/conv + all weight sizes; surfaces F9
    Boost snnAcc coverage across every connectivity mode, weight size, neuron-update
    on/off, and back-pressure at every pipeline stage:
    - tb_acc_snn_stress.v (NEW, full-chip): wait-honouring SRAM BFMs on all 7 ports;
    software golden (full/sparse/conv connectivity model + np_ref_lif) + stall-
    invariance oracle (stalled run == no-stall run, byte-identical). Matrix over
    {full,sparse,conv} x weight_sz {1..32b} x skip_neuron x np_mode x stall
    profiles incl. syn_curr arbiter contention. 1410 checks, 0 failures.
    - tb_packer_cadence.v (NEW): snnAcc write-side F8 regression (3 real packer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
    [tb_acc_snn_stress.v, tb_packer_cadence.v, tb_spike_processing.v]
2026-06-30 Fix full-mode FC weight-cache phase bug (fmiSnnAccMC)
    Gate weight_index_valid_full on act_data_valid_i so full mode only
    fetches weights for held spiking inputs (mirrors sparse/conv). Fixes
    off-by-one-low weights on wide-weight FC (weights_per_word=1), where
    the per-input base desynced from the cache's 2-cycle fetch cadence.
    Add tb T13 (single-spike sweep, 128/128) + T13b (dense) regression and
    a default-off hierarchical cycle trace. All T1-T12 byte-identical.
    [tb_acc_fmiSnnMC_processor.v, weight_generator.v]
2026-06-30 Propagate full-mode FC weight-cache gate to snnAcc/ipSnnAcc/fmiSnnAcc
    Apply the same act_data_valid_i gate on weight_index_valid_full that was
    verified in fmiSnnAccMC (0e6521d), so full mode only fetches weights for
    held spiking inputs. Fixes the latent off-by-one-low weight bug on
    wide-weight FC (weights_per_word=1) in the three byte-identical SNN
    weight_generator copies. annAcc already carried the gate.
    No-op for all existing regressions (verified):
    snnAcc: tbAccSNN 0 fail, tbWeightGen 88/88, tbAccSNNStress 1410/1410
    ipSnnAcc: tbAccSNN 0 fail, tbWeightGen 0 fail
    fmiSnnAcc: tbAccFmiSNN 0 fail
    The three weight_generator.v copies remain byte-identical to each other.
    Co-Authored-By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
    [weight_generator.v]
2026-06-30 snnAcc stress TB: F9 fixed — re-verify gapped activations as a scored hard check
    The full-mode FC weight-cache phase bug F9 (surfaced by tb_acc_snn_stress's
    gap_probe) is fixed in all variants by the parallel-session commits 0e6521d /
    8e672ac (add the missing `& act_data_valid_i` gate on weight_index_valid_full in
    weight_generator.v). Re-verify and lock it in:
    - rand_common: flip back from all-spike to random GAPPED spike patterns, so gaps
    are now a scored hard check across the whole matrix (full/sparse/conv x all
    weight sizes x skip/np_mode x stalls).
    - gap_probe: convert the directed mid-grid-gap probe from a soft NOTE into a scored
    check_eq (spikes at grid {0,1,3} must read rows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
    [tb_acc_snn_stress.v]
2026-06-30 Port focused F9 stress TBs to ipSnnAcc/annAcc/fmiSnnAcc/fmiSnnAccMC
    Confirm the full-mode FC weight-cache phase fix (the `& act_data_valid_i` gate on
    weight_index_valid_full, commits 0e6521d/8e672ac) holds end-to-end in every SNN
    accelerator variant, not just snnAcc. Each TB runs the WHOLE acc top with
    sp_skip_neuron=1 (no neuron-model golden needed -- checks the SP-accumulated
    syn_curr), wires wait-honouring BFMs on act/weight/syn_curr and ties off the rest,
    and drives GAPPED activations (act in {0,1}, 0 = a gated-out gap) across all weight
    sizes x full/sparse(/conv) under per-port stalls. Oracles: connectivity golden
    (syn[j] = sum over active i of weight[i][j]) + stall-invariance + a score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
    [tb_acc_ann_stress.v, tb_acc_fmiSnnMC_stress.v, tb_acc_fmiSnn_stress.v, tb_acc_ipsnn_stress.v]
2026-06-30 Add FMI FPGA synthesis wrapper + Vivado flow (xc7s50)
    fmi_top_fpga_wrap.v: FPGA top wrapping fmi_top (fmiSnnAccMC fabric),
    closing all memory buses into on-chip BRAMs (../shared/bram_*.v),
    *_wait_i tied low. The 7 read-only accelerator memories (weight/thresh/
    dcy_*/b_eff/scl_ada) get their write port from a top-level loader stub
    so synthesis keeps them as real BRAMs instead of folding to constant-0
    ROMs and pruning the datapath.
    Flow: create_vivado_project_fmi.tcl (200 MHz target xdc) +
    synth_fmi_relaxed.tcl (40 ns probe xdc) + elab_fmi_top_fpga_wrap.bsh.
    .gitignore: exclude vivado_fmi*/ build dirs.
    Synthesis result (Vivado 2025.2.1, xc7s50fgga484-1): clean, fits
    (BRAM 53/75 binding, LUT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
    [fmi_top_fpga_wrap.v]
2026-06-30 Add FMI place & route flow (impl_fmi.tcl)
    Place & route the FMI design from the 40 ns synth checkpoint for true
    post-route timing. Re-applies the clock XDC after open_checkpoint
    (project-mode synth .dcp does not carry create_clock; without it P&R runs
    un-timed and WNS reports NA). Downgrades NSTD-1/UCIO-1 so auto-placed I/O
    (this is a timing probe, no real pins) doesn't block; the critical path is
    internal fabric so I/O placement is irrelevant.
    Result (xc7s50fgga484-1): routes clean (zero congestion), all timing met,
    WNS +0.615 ns @ 40 ns -> true Fmax 25.4 MHz. Util: LUT 21%, FF 4%,
    BRAM 53/75 (binding), DSP 15%, IOB 149/250. Real-time (50 fps, ~123k
    cyc/frame -> ~6.2 MHz) met at ~4.1x.
    Co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
2026-07-01 Add ZU7EV cross-part synth+P&R flow for the FMI design
    flow_fmi_zu7ev.tcl + fmi_top_fpga_wrap_zu7ev.xdc: synth + place & route
    the same fmi_top_fpga_wrap on xczu7ev-ffvf1517-3-e (UltraScale+ -3) as a
    cross-part comparison vs the Spartan-7 xc7s50. Single-process synth ->
    open_run -> P&R so the create_clock stays applied.
    Result: Fmax ~97.9 MHz (vs 25.4 MHz on xc7s50, ~3.85x); same netlist,
    util tiny on the larger part (LUT 3%, BRAM 53/312=17% + 96 URAM free,
    DSP 1%). .gitignore: exclude vivado_fmi_zu7ev/ build dir.
2026-07-06 Fmax pipeline levers (all default-OFF) + log-depth pool arbiter option
    FPGA timing on the N-lane deployment showed ~10 ns single-cycle chains:
    memory read-return -> cache bypass -> decode -> next pool request -> the
    16-deep sequential grant scan -> grant/wait -> handshake enables. Three
    default-off levers cut the chain; every existing top is bit-identical
    with defaults (full regression 75/75, incl. the new equivalence TB):
    - shared_pool: ARB_FAST param — grant computed log-depth (thermometer
    mask over rr_ptr + LSB-isolate x&-x carry chain + one-hot AND-OR bank
    muxes) instead of the sequential found-flag scan. Same winner in every
    state: new tb_shared_pool_equiv.v runs scan vs fast i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
2026-07-06 dataline cache: next-line prefetch mode (REG_RETURN=2, default-off)
    REG_RETURN becomes a mode: 0 = combinational forward (default, bit-identical),
    1 = registered serve, 2 = registered serve + NEXT-LINE PREFETCH. Mode 2 keeps
    mode 1's timing cut (no mem_data_i forward anywhere) without its per-word
    refill stall: two line registers; while word w serves from one line, word w+1
    (same base) is fetched into the other, so sequential streams see back-to-back
    hits. Demand misses (row/base changes) still pay the mode-1 latency once per
    row. Random-access users gain nothing — neuron_processing clamps the LUT
    cache to mode 1. One overrun fetch per stream end (side-effect-free reads).
    Two implementati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
    [dataline_cache_with_xy.v, neuron_processing.v, tb_acc_fmiSnnMC_processor.v]
2026-07-06 scheduler: RELAX_LOOP_BARRIER option (default-off) — overlap loop iterations
    NXT/LOOPEND stall on all_tasks_drained by default (unchanged). With
    RELAX_LOOP_BARRIER=1 they consume without draining, so the front-end fetches
    and the table dispatches the next loop iteration's tasks (still strictly
    in-order) while this iteration executes. Data ordering across the boundary is
    carried by the existing buffer machinery (claim-at-dispatch,
    consume-at-completion, usage counts, colour): the barriers predate the strict
    in-order dispatch commit (both 2026-05-31, barriers first) and in-order
    subsumed the OOO hazard class they were added for. The host must then
    sequence windowed I/O off buffer state (rear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
    [scheduler.v]
2026-07-06 Hadamard: FMAX_PIPE option — split hu_compute's heavy states (default-off)
    hu_compute's three single-cycle datapath states each carried a deep
    combinational cone (~26-30 LUT levels): ST_MUL (chunk select -> 8x48 multiply
    -> variable shift -> 84-bit accumulate), ST_ACCUM (variable-shift + triple
    84-bit add) and ST_TRUNCATE (barrel shift + round + clamp). With the pool and
    cache families cut, ST_MUL bound the FPGA clock (~141 MHz).
    FMAX_PIPE=1 splits each state in two, registering the intermediate (partial
    product / shifted addends / rounded shift) in the three spare state codes.
    Costs one extra cycle per split state per element on a unit measured <0.5%
    busy. Default 0 preserves the origina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
2026-07-06 fmiSnnAccMC: REG_MC_INDEX accumulator (default-off) for conv weight-index
    Replace the per-cycle 3-DSP weight_index_mc_conv multiply chain (the 4-D
    (Cout,Cin,Ky,Kx) flatten) with a lockstep index accumulator, behind a
    default-off param REG_MC_INDEX (=0 keeps the original combinational path,
    bit-identical):
    - mc_within_acc_r: within-input part (+1/step; +cout_incr on cout advance),
    reset per input neuron in lockstep with the kx/ky/cout counters
    - mc_cin_base_r: per-input cin*(Ky*Kx) base (constant across an input's sweep),
    settle-gated one cycle on channel change (cf. jabra REG_WROW_BASE)
    Verified bit-exact both ways: block T1-T13 + fmi_top C2c (g3->g6). ZU7EV clean
    A/B (only REG_MC_I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
    [weight_generator.v]
2026-07-10 top_module: derive cm_buffer_info long-slot id offsets (were TGT_COUNT_SZ=3 hardcodes)
    The scheduler entry's long-slot id positions move with TGT_COUNT_SZ
    (SLOT_LONG_SZ); flexman.v / example_app_top.v / fmi_top.v extracted the
    config_manager's src2/src3 buffer ids with hardcoded [32:29]/[41:38] — the
    TGT_COUNT_SZ=3 offsets — while all three default TGT_COUNT_SZ=4, so those
    slices read ntgt bits. Benign today (BBA src2/src3 values are unused: cfg
    images carry explicit addresses and accelerators don't decode buffer_info
    long slots) but wrong for any future BBA-addressed flow. Now derived
    (LS0/1/2_ID_START from SLOT_LONG_SZ). Stale layout comments corrected to the
    default TGT_COUNT_SZ=4 val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
    [example_app_top.v, flexman.v, fmi_top.v, scheduler.v]
2026-07-21 Fix async-reset/sync-clear idiom in the three tops (ASIC portability)
    if (reset || (sch_start_new_block && ...)) inside posedge-clk-or-posedge-
    reset blocks is accepted by Vivado/Xcelium but rejected by Yosys FF
    inference (and flagged by strict ASIC lint). Split the synchronous clear
    into an else-if — bit-identical behaviour — at flexman.v (8 sites),
    example_app_top.v (8), fmi_top.v (2). shared/packer.v:132 untouched
    (sync-reset block; idiom legal there).
    Found by a downstream open-PDK ASIC mirror flow (its asic/ tree); the
    same fix lands in the two deployment tops in that repo.
    Verified: full regression 75/75 PASS (incl. all sim_fmi_top*); the
    deployment M1/M2 and dense sims bit-exact.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
    [example_app_top.v, flexman.v, fmi_top.v]
2026-08-01 fix(fpga): repoint hoisted dataline_cache_with_xy/slice_and_align/packer to shared/
    These 3 files moved snnAcc/ -> shared/ (hoist commit 3c1bd1a); the generic
    create_vivado_project.tcl still referenced snnAcc/ and would fail synth with
    'file does not exist'. The FMI flow tcls were already fixed at the hoist; this
    was the last stale generic copy.
2026-08-02 scheduler: additive front-end debug taps (KV260 round-2 bring-up)
    Clement's 30-Jul board report showed the scheduler wedging a few instructions
    into the golden program with everything observable bit-clean: CRCs stable,
    acc_busy=0, buffers in a legal state. The board logs could not distinguish
    WHY instruction consumption stopped, which cost a round trip.
    Add two read-only debug outputs so the host can see the front-end directly:
    dbg_frontend_o - table occupancy and per-entry readiness, fill_in_flight,
    the two-word fetch handshake, prog run/stop/pause,
    dispatch_in_flight, cm_busy and acc_available
    dbg_inst_word_o - the instruction word currently h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
2026-08-05 scheduler: SOFT_RESET (ctrl reg 6) — re-run a program without a logic reset
    Postmortem §4: after a program STOPs there was no way to run it again, forcing a
    pl_resetn0 pulse plus a full image reload — including the 348k-word weight store
    — once per utterance. That made continuous audio and power campaigns impractical.
    Diagnosed off-board rather than assumed: a bare LOAD_PC+START DOES re-fetch and
    re-create the task entry — the PC visibly moves, the front end is fine — but the
    entry can never become ready, because its target buffers are still FULL from the
    previous run and a TARGET slot requires the buffer FREE:
    [after RESTART] dbg_fe=0x1f06a501 ev=0b0001 rtg=0b0000 fill_in_fli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
    [scheduler.v]
2026-08-07 flexman_fpga_wrap: drive the bba read stall instead of tying it low
    u_bba_mem is a bram_tdp -- a REGISTERED read -- but fill_unit asserts
    fu_bba_rd_o and enters ST_BBA_WAIT on the same edge, then samples fu_bba_data_i
    in that state. With fu_bba_mem_wait_i tied to 1'b0 it can never stall, so every
    FILL latches the PREVIOUS fill's buffer base address. That is only correct when
    one buffer is refilled back to back, which is why the corruption is intermittent
    rather than total: a program that cycles between buffers gets a wrong base on
    every change.
    fill_unit already carries fu_bba_mem_wait_i for exactly this purpose and honours
    it by sitting in ST_BBA_WAIT with the request still asserted. This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
    [flexman_fpga_wrap.v]
2026-08-08 test(flexman-fpga): tb_flexman_wrap — first simulation of the synthesis top
    No testbench had ever instantiated flexman_fpga_wrap. tb_flexman.v drives the
    `flexman` CORE with behavioural arrays whose reads are combinational and whose
    wait inputs are tied to zero; Vivado synthesises the wrapper, where all 19
    memories are shared/bram_*.v primitives with registered reads. That gap is what
    let the bba bug live ~3 months behind green regressions.
    Adds tb_flexman_wrap.v (T1-T4 retargeted from tb_flexman, plus T5/T6) and
    sim_flexman_wrap.bsh. All of T1-T5 pass.
    T5 is the bba regression and is verified to have teeth: it PASSES normally and
    FAILS under +define+NEG_CTRL_BBA, which forces fu_bba_wai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
    [tb_flexman_wrap.v]
2026-08-08 test(fmi-fpga): tb_fmi_top_wrap — first simulation of fmi_top_fpga_wrap
    tb_fmi_top.v drives the `fmi_top` CORE with prog/cfg/bba as behavioural arrays
    with COMBINATIONAL reads. Vivado synthesises fmi_top_fpga_wrap, where cfg and
    bba are registered bram_sdp. fmi_top's config_manager had never been simulated
    against registered config reads.
    Reproduces tb_fmi_top's T9B and T9A goldens verbatim on the wrapper: 1920
    syn_curr + 60 spike words per variant, checked through both the POOL_RD_BASE AXI
    window and the backdoor. All match bit-exactly, so the registered cfg/bba path
    is confirmed sound.
    Note fmi_top has no fill_unit (NUM_HW_ACCELERATORS=2), so the bba wait-state bug
    affecting the other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
    [tb_fmi_top_wrap.v]
2026-08-08 test(flexman-fpga): make the verdict state that T6 was excluded
    Running with +define+RUN_T6 printed a bare [VERDICT] PASS directly underneath a
    visible [T6] FAIL. T6 is deliberately excluded from the verdict — it probes a
    pre-existing CORE defect, not a wrapper regression — but the output should say
    so rather than leave the reader to reconcile the two lines.
    [tb_flexman_wrap.v]
2026-08-08 fix(test): T6 was blaming back-to-back FILL; the real defect is the fill constant
    Simon challenged the earlier claim that back-to-back FILLs are broken, on the
    grounds that deployed code does them and works. He was right and the claim was
    wrong.
    Every deployed program does back-to-back FILLs and passes: flexman_program has 6
    consecutive pairs at pc0..pc10, one deployment program has 11, another 4 — decoded from the
    committed .hex images, 80 FILLs across six programs.
    Sweeping the FILL's second word (the 32-bit fill constant) isolates the actual
    trigger — its low 3 bits:
    0x00000000 000 TASK PASS 0x00000002 010 STOP PASS
    0x00000001 001 JUMP FAIL 0x22222222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
    [tb_flexman_wrap.v]
2026-08-09 docs(test): record the traced mechanism for T6, replacing my wrong guess
    The T6 comment claimed the leak was 'a timing window around task_w2_pending_r,
    not a missing gate'. A cycle-by-cycle trace shows the opposite, and the guess was
    inst_consumed ORs in inst_consumed_w2 outside the decode gate, which is
    deliberate — goto_nxt = inst_consumed is how the PC advances past a two-word
    instruction's second word. But do_jump is keyed off the same inst_consumed while
    the decoder is combinational and ungated, so on the cycle the FILL constant is
    consumed as word 2 it is also decoded, and a JUMP tail redirects the PC to
    constant[12:3]. Traced: 0x11111111 sends pc 1 -> 546 = 0x11111111[12:3].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
    [tb_flexman_wrap.v]
2026-08-09 fix(scheduler): gate instruction decode on inst_valid_for_decode
    The inst_is_* flags are a raw combinational decode of inst_word. But inst_word
    also carries the SECOND word of a two-word instruction — and a FILL's second word
    is a free 32-bit constant. On the cycle that word is consumed, the constant was
    being decoded as an instruction and acted upon.
    inst_valid_for_decode already knows the difference (& ~task_w2_pending_r) and
    correctly reads 0 on that cycle. The problem was that several consumers bypassed
    it and keyed off inst_consumed instead — and inst_consumed deliberately ORs in
    inst_consumed_w2 OUTSIDE that gate, because goto_nxt = inst_consumed is what
    advances the PC past word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
    [scheduler.v]
2026-08-09 test(flexman-fpga): T6/T7 become standing regressions for the decode gate
    The scheduler decode fix (fb8ec9c) makes T6 pass, so it no longer belongs behind
    +define+RUN_T6 as a known-failing probe. Enables it by default, adds T7 for the
    second exploit found while auditing, and folds both into the verdict.
    T6 FILL constant 0x11111111 (low bits 001 = JUMP)
    pre-fix: do_jump asserts, prog_counter <= inst_word[12:3], pc 1 -> 546;
    a single 4-word FILL issues 23 pool writes and the program re-runs.
    T7 FILL constant 0x000002BE (low bits 110 = LOOP, id [5:3]=7, max [31:6]=10)
    pre-fix: loop_counter_r[7] <= 10, loop_restart_r[7] <= 2, silently — fill
    DATA corrupting loop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
    [tb_flexman_wrap.v]
2026-08-19 perf(config_manager): pipeline the config push, 49 -> 34 cycles (19 opt-in)
    The config push is SERIAL in front of every compute task, not hidden under it:
    sch_table.v:125 only dispatches to a free accelerator with ~cm_busy_i, and the
    accelerator only starts on cm_config_finished_o (flexman.v: acc_start_new_block
    = cm_config_finished_o). The config engine spent 3 cycles per word with no
    overlap — read / wait / write, then start the next word's read — so at the
    deployed WORDS_PER_CONFIG=16 every annAcc and Hadamard task paid 49 dead cycles
    before doing any work.
    Invisible at nblocks=4, where a deployment task runs ~28k cycles. Not invisible at
    nblocks=40, where the average task is ~150-30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
2026-08-20 test(hadamard): cover the SHIPPED hu_compute config, and assert its throughput
    tb_hu_compute instantiated the DUT without overriding FMAX_PIPE, and
    tb_hadamard_unit overrode neither FMAX_PIPE nor REG_RETURN. So both Hadamard unit
    testbenches only ever built FMAX_PIPE=0 — while the deployment tops all pass
    FMAX_HU_PIPE=1. The configuration we actually ship had NO unit-level coverage at
    all; it was only ever exercised full-chip.
    Neither testbench drove pak_full_i either, so back-pressure was unverified at unit
    level. That is the one input that can corrupt data if the producer ignores it:
    shared/packer.v:121-126 latches pak_index_latched/last on ANY pak_write_i
    regardless of buffer_full.
    Th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
2026-08-20 perf(hadamard): declare the multiply at its real width — 12 DSPs -> 3, Fmax +36%
    hu_compute held 12 of the whole Monarch design's 21 DSP48E2 — 57% of every DSP on
    the chip — for a multiply that is nominally 8 bits x 48 bits and needs about 2.
    Cause: both operands were sign-extended to the accumulator width BEFORE the
    multiply, so the expression read as an 84 x 84 signed multiply and Vivado never
    pruned it back to the 8 significant bits of the chunk. Narrowing to 9 x 49 -> 58
    bits is the SAME arithmetic: the true product cannot exceed 2^54, so the old
    truncation to ACC_BITS never removed anything. The sign convention is unchanged —
    top chunk signed, lower chunks unsigned.
    Measured,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
2026-08-20 feat(scheduler): a second, wide TASK form — 7-bit usage counts, ISA-compatible
    Real cycle counts for nblocks = 8/20/40 are blocked on one field: the per-slot
    usage count `ntgt` is 4 bits (max 15), and those variants need 21, 45 and 85.
    TASK word 2 is exactly full — 2-bit sentinel plus three long slots of
    [mode(2)+id(4)+ntgt(4)] = 30 of 30 usable bits. Widening ntgt to 7 needs 39, so
    within one two-word format you can have THREE slots with a small count or TWO with
    a large one. The projects sit on opposite sides of that trade: Monarch never uses
    the third long slot but needs ntgt 85; Bosch uses all three in 3 of its 5 TASKs
    with every ntgt = 1. No single two-word format serves both.
    So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
2026-08-20 docs(scheduler): record WHY FILL's wide ntgt is build-wide — bit 7 is reserved, not absent
    The wide-TASK commit justified FILL's build-wide ntgt by claiming word 1 had no
    spare bit. That was wrong, and read off the field list rather than counted.
    Bit 7 IS free: buf_id occupies [6:3] and colour sits at [8]. Verified clear in all
    111 FILL instructions across every committed program image. So FILL could have had
    a per-instruction selector exactly like TASK's bit 31, and the whole extension
    could have been backward compatible with no build-wide behaviour at all.
    It is deliberately NOT spent, for a reason worth recording because it is easy to
    rediscover and get wrong: bit 7 is free only while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
    [scheduler.v]
2026-08-20 feat(scheduler): widen cfg_id in the wide TASK — 512 configs, in word 3
    The wide TASK form lifted the usage-count ceiling; cfg_id is the next one. It is
    7 bits in TASK word 1 (128 configs), and Monarch needs 172 at nblocks=20 and 329
    at nblocks=40. Word 1 has no room left (bit 31 became the wide selector), so the
    wide form carries cfg_id in WORD 3 instead — wholly and contiguously, above
    slot 5, in the 19 bits that were already spare there.
    Contiguous rather than split, for the same reason the usage counts are: you can
    read it straight out of a hex dump, and it rescales with the parameters. A wide
    TASK ALWAYS takes cfg_id from word 3 and word 1's cfg field is left zero, so
    there is one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
2026-08-22 feat(scheduler): optional 2-deep task overlap per accelerator (default OFF)
    Lets one accelerator accept its NEXT task while the current one drains its
    output stage. Everything is behind OVERLAP_ACC_MASK, default 0, so Bosch, FMI
    and every existing top are bit-identical: regression 82/82, Bosch
    siren_detector_top all tests + e2e 299/299.
    acc_hw_buffer_tracker gains DEPTH. DEPTH=1 is the original code kept VERBATIM
    in its own generate branch. DEPTH=2 holds two slot sets in an in-order FIFO —
    without it the single slot register is overwritten by the early dispatch and
    sch_buffer_state then frees/fills the WRONG buffers on the older task's
    completion. acc_free_o stays REGISTERED in both branc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
    [acc_hw_buffer_tracker.v, example_app_top.v, flexman.v, fmi_top.v, sch_buffer_state.v, scheduler.v, tb_acc_hw_buffer_tracker.v, tb_sch_buffer_state.v]
2026-08-22 tools: add sd2npz.py — the converter nsnet2_deploy_monarch already referenced
    nsnet2_deploy_monarch.py's comment points at "tools/sd2npz.py" to convert the
    nblocks=20/40 checkpoints (which ship only config.json + a g_best state dict,
    no ONNX export) into the state-dict npz that dims_from_npz /
    load_monarch_tensors_npz consume. The tool was never committed, so those two
    block sizes could not be deployed from a clean tree.
    Reads the torch.save archive directly — zip + pickle + raw storages, with a
    custom find_class/persistent_load — because there is no torch on the build
    machines. Re-adds the "base." prefix the ONNX names carry and the state dict
    does not.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
2026-08-22 feat(scheduler): sub-buffer disjoint hint — unblock overlapped dispatch
    The 2-deep tracker landed in 2eb0176 but delivered 0.08%: the buffer model
    never let the next task become ready. sch_entry makes an RW slot wait for the
    buffer to be `full`, and the claim-on-dispatch clears `full`, so consecutive
    tasks writing one buffer serialise on each other's COMPLETION — which is
    exactly the output-stage drain the overlap exists to hide.
    Every one of those stalls is a FALSE dependency for a block-diagonal layer:
    each block writes a disjoint sub-range of one output buffer. Checked, not
    assumed — across nblocks=4/8/20/40, of 24/56/152/309 adjacent task pairs
    sharing a buffer, ZERO have overlapp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
    [acc_hw_buffer_tracker.v, buffer_state_entry.v, sch_buffer_state.v, sch_entry.v, sch_table.v, scheduler.v, tb_acc_tracker_d2.v]
2026-08-25 perf(hadamard): HU_II — pipeline hu_compute, 6.01 -> 2.00 cyc/element
    The Hadamard costs ~9,622 cycles of EVERY Monarch frame regardless of nblocks
    (4 calls over the 400-element GRU hidden state), so it is a fixed cost that
    dilutes as blocks get finer -- 0.9% of an nblocks=4 frame, 6.2% of an
    nblocks=40 one. The sequential FSM spent mul_total + 4 cycles per element and
    only mul_total of those are real work.
    TWO CYCLES IS THE FLOOR for the 16-bit Z Monarch uses. The multiply is the
    only multi-cycle SHARED resource -- 8 bits of Z per cycle into one accumulator
    -- so II = mul_total, and the other four cycles are pure pipeline overhead.
    A 5-stage pipeline (align / multiply / accumulate / trun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
    [hadamard_unit.v, hu_compute.v, tb_hu_compute.v]
2026-09-02 fix(scheduler): read the disjoint hint at the ISA's WIDE position, not the instance's
    The wide TASK ENCODING is fixed by the toolchain -- isa.DISJOINT_BIT =
    SLOT_LONG_SZ_WIDE + CFG_ID_SZ_WIDE = 13 + 9 = 22 -- whatever CFG_ID_SZ a given
    instance carries. Reading it at SLOT_LONG_SZ + CFG_ID_SZ therefore tracks the
    wrong thing. The old comment said the derived form "tracks the field widths",
    which is backwards, and it bit: a variant whose config count fits 7 bits was
    parameterised CFG_ID_SZ=7, the hint was read at bit 20, EVERY disjoint hint was
    lost, and the SP/NP overlap collapsed from 13,868 to 454 cycles -- 1.85% of frame
    time at nblocks=8, with the run still bit-exact so no test failed.
    N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
    [scheduler.v]
2026-09-04 feat(scheduler): cfg_id 9 -> 12 bits, and PIN the disjoint hint at bit 31
    Two-factor Monarch at nblocks=40 needs 964 configs against CFG_MAX_WIDE=511, so
    its program could not be assembled at all. Widening cfg_id is the obvious half.
    The half that matters more is the hint. It sat IMMEDIATELY ABOVE cfg_id, so every
    cfg_id widening moved it -- and a mis-positioned hint is a BIT-EXACT regression:
    that adjacency already cost 1.85% of frame time at nblocks=8 on 2026-09-01 with no
    test failing (81205eb). A field that must move whenever a neighbour grows is a
    standing trap, so it is now PINNED at bit 31, structurally independent of cfg_id,
    TGT_COUNT_SZ, and any instance parameterisation. cfg_id ca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
    [sch_entry.v, scheduler.v, tb_sch_wide.v]
2026-09-17 feat(shared): optional BRAM read gating (RD_GATE, default OFF)
    bram_sdp/bram_sp/bram_sdp_uram read their arrays on EVERY clock edge --
    `dout <= mem[raddr]` is unconditional, as the comment in bram_sdp says
    outright. Measured cost on a downstream Bosch xczu7ev build with the design
    idle (clock running, every read strobe low): 16 mW in BRAM. Idle dominates
    the deployed duty cycle, so that power is burned doing nothing.
    Add `parameter RD_GATE = 0` plus an `re` input, generate-guarded:
    RD_GATE=0 (default) -- unchanged, bit-identical, `re` unread. Every
    existing instantiation across FlexMan, fmi and
    jabra is untouched.
    RD_GATE=1 --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
    [bram_sdp.v, bram_sdp_uram.v, bram_sp.v, tb_bram_rdgate.v]
2026-09-17 feat(shared): NO_URAM fallback for families without UltraRAM (default OFF)
    bram_sdp_uram had exactly two branches: ALTERA -> M10K, else -> ram_style="ultra".
    There was NO branch for a Xilinx family that has no UltraRAM sites, and that path
    had never been synthesised -- on such a part it would apply an attribute with no
    target primitive, and whether Vivado falls back silently, warns, or errors was
    simply unknown.
    Add a third, default-off branch forcing ram_style="block". A build that does not
    define NO_URAM is unchanged: verified by a control synthesis with no defines,
    which reproduced the existing result exactly (8649 LUT, 8.5 BRAM tiles, 4 URAM).
    Measured on a downstream deployment (xczu7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
    [bram_sdp_uram.v]
2026-09-23 feat(shared): portable gated-clock cell + enable logic (default OFF)
    Two modules, both inert unless asked for. clk_gate is the cell itself:
    GATE_STYLE 0 (default) is a pass-through, so a build that does not opt in is
    identical to one that never had this. Styles 1-3 select BUFGCE, an Altera
    clock-control buffer, or a generic latch-based ICG for an ASIC flow; all three
    implement the same transparent-low enable latch, which is what BUFGCE does
    internally and is why the behavioural fallback is a faithful model rather than
    an approximation. The real Xilinx primitive is instantiated only under
    XILINX_BUFGCE, so the unit tests need no vendor library.
    clk_gate_ctrl generates the enable from a busy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
2026-09-29 feat(scheduler): PROG_MEM_SYNC — fetch from a 1-cycle SRAM program store (default OFF)
    The fetch consumes prog_mem_data_i the cycle after the request, at whatever
    prog_counter_r holds then. A combinational store returns mem[prog_counter_r]
    regardless; an SRAM returns the word at the address it sampled, one PC stale
    after a consume, so the instruction executes twice (Bosch 7-Aug, pc=28).
    With PROG_MEM_SYNC=1 the read address is the PC register's NEXT value, so the
    SRAM output equals mem[prog_counter_r] every cycle -- exactly the combinational
    store's value. The fetch FSM is untouched and the cost is ZERO cycles. New
    additive port prog_mem_rd_o reads only when that next PC differs (or after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
2026-10-01 fix(hadamard): HU_II=1 dropped an element when a packer stall began in a ready cycle
    Reported by Clement Laroche (butterfly-engine bring-up, 1-Oct): with HU_II=1
    and wait states on the shared pool, the Hadamard unit drops elements (wrong
    outputs at the dropped positions; at 25% waits the run hangs).
    Root cause: in the HU_II pipeline ready_o is a REGISTER (~a_vld_nxt &
    ~p_stall of the previous cycle), but a_accept also required ~p_stall of the
    CURRENT cycle. hadamard_unit fires take = all_valid & compute_ready on the
    registered ready_o alone and advances all four input streams, so a stall
    starting in a ready cycle refused an element the streams had already given
    up. A continuous stream keeps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
    [hu_compute.v, tb_hu_compute.v]
2026-10-12 feat(scheduler): OVERLAP_DEPTH -- up to three tasks in flight on a masked accelerator (default 2, bit-identical)
    acc_hw_buffer_tracker gains gen_depthn (DEPTH>=3): the same in-order slot-set
    FIFO, DEPTH deep; acc_ready_next_i licenses every accept beyond the first
    (free while 1..DEPTH-1 in flight and the accelerator can take one more, full at
    DEPTH); overflow/underflow $fatal. DEPTH=1 and DEPTH=2 branches untouched.
    sch_buffer_state/scheduler plumb OVERLAP_DEPTH (default 2); at 3 the masked
    accelerator's pending-completion counter is 3 bits. scheduler.v documents that
    a DISJOINT hint must then cover every earlier in-flight writer and refuses
    OVERLAP_DEPTH outside 2..3 (buffer_state_entry's 2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
2026-10-28 shared_pool: PTR_RST (default 0) -- optional async reset of the RR pointers
    The pointers' start value comes from an initial, which synthesis drops, so
    in a netlist they power up X. Requester 0 is immune (its 'k > rr_ptr' term
    is constant 0), so every gate-level run so far worked; any other
    requester's first request waits on X. PTR_RST=1 resets them via rst_i to
    the same NUM_REQ-1. Default 0: rst_i unused, existing instantiations need
    not connect it; Yosys default synthesis identical (6,424 cells, 36 flops).
    tb_shared_pool (66,077 checks) and tb_shared_pool_equiv pass.
